tonyzhangforest/Intelligent-Toilet-Controller/智能马桶控制系器统需求.pdf

智能马桶控制器系统需求
基本功能：
⚫ | 水温控制，水温传感器
⚫ | 喷嘴位置控制，电机控制
⚫ | 喷嘴流量控制，阀门控制，流量传感器
⚫ | 空气泵控制
⚫ | 风温控制，风温传感器
⚫ | 座圈加热，温度传感器
⚫ | 按键面板和指示灯夜灯
⚫ | 电源转换，输出 12V/2A
以上各传感器等部件的控制全部在一颗 MCU 搞定，水温风温和座圈温均需要配套相关保险 机制，以免对人体造成伤害，另外需要有漏电保护机制；

选配：
⚫ | 人体感应装置，毫米波雷达芯片控制，包括自动掀盖和自动感应冲水以及脚感冲水；
⚫ | 紫外线功能；
⚫ | 电子除臭或活性炭；
⚫ | 联网功能；
⚫ | 支持外接电池（停电时使用）
⚫ | 定时及节能功能

疑问：
⚫ | 进水是否需要过滤；
⚫ | 防水等级；
⚫ | 是否需要相关行业认证；
⚫ | 是否需要遥控器；
⚫ | 按键光感何解；
