tonyzhangforest/Intelligent-Toilet-Controller/副本SHRZ_RZ01_V1.0-BOM20200424.xlsx

SHRZ_RZ01_V1.0-BOM
序号 | 名称 | 单板数量 | 位号 | 物料编码 | 规格 | 封装 | 供应商 | 供应商料号 | 备注
1 | 直插X2安规电容 | 1 | C1 | X2/1uF/275V | 15mm脚距 1uF 275V | X2-1770X960 |  |  | 参考https://detail.tmall.com/item.htm?id=544635025633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
2 | 直插电解电容 | 1 | C2 | RNU1C471MDN1PH/470uF/25V | RNU1C471MDN1PH | CAPPR500-1000X1250
3 | 直插电解电容 | 2 | C3,C4 | 47uF/400V | 47uF 400V 16*20mm | CAPPR750-1600X2000 |  |  | https://detail.tmall.com/item.htm?id=44162474692&cm_id=140105335569ed55e27b&abbucket=8&skuId=3832824949122
4 | 贴片陶瓷电容 | 1 | C5 | 1uF/100V/1206 | 1uF 100V 1206 X7R | C1206
5 | 直插Y2安规电容 | 1 | C6 | DE2E3KY222MA2BM01/2200pF/250V | DE2E3KY222MA2BM01 | dip-500p-800x500 | 国巨 | swssaas
6 | 贴片陶瓷电容 | 10 | C7,C11,C14,C19,C20,C21,C22,C23,C27,C30 | RZC100102 | 0.1uF 50V 0603 | C0603
 |  |  |  |  |  |  | 三星电子 | CL10F104ZB8NNNC
7 | 贴片陶瓷电容 | 2 | C8,C41 | 1nF/50V/6 | 1nF 50V 0603 X7R | C0603 | 三星电子 | CL10B102JB8NFNC
8 | 贴片陶瓷电容 | 1 | C9 | 4.7uF/35V/8 | 4.7uF 35V 0805 X7R | C0805 | 三星电子 | CL21A475KLCLQNC
9 | 贴片陶瓷电容 | 6 | C10,C12,C13,C15,C26,C29 | 1uF/25V/6 | 1uF 25V 0603 X7R | C0603 | 三星电子 | CL10A105KA8NFNC
10 | 贴片陶瓷电容 | 2 | C16,C17 | 10pF/50V/6 | 10pF 50V 0603 X7R | C0603 | 三星电子 | CL31B106KBHNFNE
11 | 贴片陶瓷电容 | 3 | C18,C31,C42 | 10uF/16V/8 | 10uF 16V 0805 X7R | C0805 | 三星电子 | CL21B106KOQNFNE
12 | 贴片陶瓷电容 | 2 | C24,C25 | 20pF/50V/6 | 20pF 50V 0603 X7R | C0603 | 三星电子 | CL10C200JB80PNC
13 | 贴片陶瓷电容 | 2 | C28,C43 | 0.1uF/50V/6/NC | 不贴 | C0603
14 | 直插X2安规电容 | 4 | C32,C33,C34,C35 | X2/0.01uF/275V | 10mm脚距 0.01uF 275V | x2-1300x600 |  |  | 参考https://detail.tmall.com/item.htm?id=544635025633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
15 | 贴片陶瓷电容 | 5 | C36,C37,C38,C39,C40 | 0.01uF/50V/6 | 0.01uF 50V 0603 X7R | C0603 |  | CL10B104JB8NNNC
16 | 贴片全桥整流桥 | 1 | D1 | DF06S | DF06S | DF06S
17 | 贴片单向TVS管 | 1 | D2 | SMBJ120A-13-F | SMBJ120A-13-F | SMB
18 | 贴片肖特基二极管 | 1 | D3 | MURS360S | MURS360S | SMB
19 | 贴片超快恢复二极管 | 1 | D4 | US1K-E3/61T | US1K-E3/61T | SMA |  | Vishay
20 | 贴片红色LED | 1 | D5 | RLED | 红色发光二极管 0603 | led0603
21 | 贴片双向ESD管 | 5 | D10,D11,D12,D13,D14 | SS14 | SS14,SMA | SMA
22 | 贴片肖特基二极管 | 4 | D15,D16,D17,D18 | TMG8C80F | TMG8C80F | TO-220 |  | SanRex
23 | 直插Triac | 8 | ED1,ED2,ED3,ED4,ED5,ED6,ED7,ED8 | ESD9B5V | 贴片双向ESD管 | D0402
24 | 直插快熔断陶瓷保险丝 | 1 | F1 | 250AC/10A/3.6*10 | 带引线快融陶瓷保险丝 250V 10A 3.6mm*10mm | DIP-F360X1000
25 | 直插快熔断陶瓷保险丝 | 1 | F2 | 250AC/0.5A/3.6*10 | 带引线快融陶瓷保险丝 250V 0.5A 3.6mm*10mm | DIP-F360X1000
26 | 直插2脚连接器 | 2 | J1,J14 | CON2 | 7.8mm间距插件，网上没看到实物图片 | DIP780-1580x850-2N
27 | 直插2脚连接器 | 1 | J2 | CON2 | 2.54单排针直针2P | DIP254P-1X2 |  |  | https://item.taobao.com/item.htm?id=549095567003&ali_trackid=1_d2534dbc00c9d3ae4bf6c6e66d614638
28 | 直插4脚连接器 | 1 | J3 | CON4 | XH2.54MM连接器直针插座4P | XH2-54-1X4 |  |  | https://detail.tmall.com/item.htm?id=13300685584&ali_trackid=1_cd4177326dbb2e69d96db1ddd9ae0f90
29 | 直插3脚连接器 | 3 | J4,J20,J21 | CON3 | XH2.54MM连接器直针插座3P | XH2-54-1X3 |  |  | https://detail.tmall.com/item.htm?id=13300685584&ali_trackid=1_cd4177326dbb2e69d96db1ddd9ae0f90
30 | 直插2脚连接器 | 10 | J5,J6,J7,J8,J9,J10,J16,J17,J18,J19 | CON2 | XH2.54MM连接器直针插座2P | XH2-54-1X2 |  |  | https://detail.tmall.com/item.htm?id=13300685584&ali_trackid=1_cd4177326dbb2e69d96db1ddd9ae0f90
31 | 直插5脚连接器 | 2 | J11,J12 | CON5 | XH2.54MM连接器直针插座5P | XH2-54-1X5 |  |  | https://detail.tmall.com/item.htm?id=13300685584&ali_trackid=1_cd4177326dbb2e69d96db1ddd9ae0f90
32 | 直插2脚连接器 | 2 | J13,J15 | CON2 | 5557端子接插件 直针 | 5569-420-2N |  |  | https://item.taobao.com/item.htm?id=12846741848
33 | 直插6脚连接器 | 1 | J22 | CON6 | XH2.54MM连接器直针插座6P | XH2-54-1X6 |  |  | https://detail.tmall.com/item.htm?id=13300685584&ali_trackid=1_cd4177326dbb2e69d96db1ddd9ae0f90
34 | 直插2脚端子 | 1 | J23 | CON2 | 6.3H脚PC板插片焊片 | DIP480P-2N |  |  | https://item.taobao.com/item.htm?id=528256841030&ns=1&abbucket=19
35 | 直插4脚连接器 | 1 | J24 | CON4A | 直插双排4脚跳线帽插针 | DIP254P-2X2
36 | 贴片磁珠 | 2 | LFB1,LFB2 | CBW160808U601T/1A/6 | CBW160808U601T | L0603
37 | 直插压电蜂鸣器 | 1 | LS1 | SPEAKER | 1407型压电蜂鸣器 | B1407 |  |  | 有源无源待定
38 | 直插共模电感 | 1 | L1 | 5mH/1.5A/7*8 | 5mH，1.5A，7mm*8mm | L_7X8-4 |  |  | https://detail.tmall.com/item.htm?spm=a1z0d.6639537.1997196601.46.75637484LeTp8T&id=41299186690
39 | 贴片功率电感 | 1 | L2 | NPI31W471MTRF/470uH/0.5A | NPI31W471MTRF | NPI31W471MTRF
40 | 贴片三端基准电压源 | 1 | Q1 | TL432IDBZ | TL432IDBZ | sot23
41 | 贴片三极管 | 3 | Q2,Q10,Q11 | MMBT3906LT1G | PNP | SOT23
42 | 贴片三极管 | 7 | Q3,Q4,Q5,Q6,Q7,Q8,Q9 | MMBT3904LT1G | NPN | SOT23
43 | 贴片MOS管 | 1 | Q12 | AO3407A/NC | 不贴 | SOT23
44 | 直插功率热敏电阻 | 1 | RT1 | NTC10D-9 | NTC10D-9 | ntc10d-9
45 | 贴片电阻 | 4 | R1,R2,R102,R103 | 1M/1206 | RES,1M,5%,0.25W,1206 | R1206
46 | 贴片电阻 | 1 | R3 | R050/2512 | RES,0.05,1%,2W,2512 | R2512
47 | 贴片电阻 | 1 | R17 | R500/2512 | RES,0.5,1%,2W,2512 | R2512
48 | 贴片电阻 | 1 | R4 | 365K/6 | RES,365K,5%,0.1W,0603 | R0603
49 | 贴片电阻 | 1 | R5 | 10R/8 | RES,10,5%,0.125W,0805 | R0805
50 | 贴片电阻 | 1 | R6 | 301K/1%6 | RES,301K,5%,0.1W,0603 | R0603
51 | 贴片电阻 | 13 | R7,R24,R25,R26,R36,R59,R60,R71,R72,R88,R89,R90,R91 | 10K/6 | RES,10K,5%,0.1W,0603 | R0603
52 | 贴片电阻 | 1 | R8 | 71.5K/1%/6 | RES,71.5K,1%,0.1W,0603 | R0603
53 | 贴片电阻 | 1 | R9 | 22R/8 | RES,22,5%,0.125W,0805 | R0805
54 | 贴片电阻 | 1 | R10 | 19.1K/1%/6 | RES,19.1K,1%,0.1W,0603 | R0603
55 | 贴片电阻 | 1 | R11 | 44.2K/1%/6 | RES,44.2K,1%,0.1W,0603 | R0603
56 | 贴片电阻 | 1 | R12 | 5.23K/1%/6 | RES,5.23K,1%,0.1W,0603 | R0603
57 | 贴片电阻 | 1 | R13 | 1.24K/1%/6 | RES,1.24K,1%,0.1W,0603 | R0603
58 | 贴片电阻 | 22 | R14,R22,R23,R27,R32,R33,R34,R37,R38,R39,R40,R44,R46,R49,R50,R79,R80,R81,R84,R85,R92,R93 | 1K/6 | RES,1K,5%,0.1W,0603 | R0603
59 | 贴片电阻 | 1 | R15 | 38.3K/1%/6 | RES,38.3K,1%,0.1W,0603 | R0603
60 | 贴片电阻 | 1 | R16 | 205K/1%/6 | RES,205K,1%,0.1W,0603 | R0603
61 | 贴片电阻 | 1 | R18 | 18.7K/1%/6 | RES,18.7K,1%,0.1W,0603 | R0603
62 | 贴片电阻 | 1 | R19 | 19.6K/1%/6 | RES,19.6K,1%,0.1W,0603 | R0603
63 | 贴片电阻 | 1 | R20 | 10K/1%/6 | RES,10K,1%,0.1W,0603 | R0603
64 | 贴片电阻 | 1 | R21 | 1M/6/NC | 不贴 | R0603
65 | 贴片电阻 | 3 | R28,R29,R45 | 100R/6 | RES,100,5%,0.1W,0603 | R0603
66 | 贴片电阻 | 3 | R30,R31,R78 | 4.7K/6 | RES,4.7K,5%,0.1W,0603 | R0603
67 | 贴片电阻 | 11 | R35,R41,R42,R43,R48,R51,R52,R62,R63,R73,R75 | 100K/6 | RES,100K,5%,0.1W,0603 | R0603
68 | 贴片电阻 | 1 | R47 | 220R/6 | RES,220,5%,0.1W,0603 | R0603
69 | 贴片电阻 | 8 | R53,R54,R61,R64,R65,R66,R74,R76 | 200R/8 | RES,200,5%,0.125W,0805 | R0805
70 | 贴片电阻 | 8 | R57,R58,R69,R70,R104,R105,R106,R107 | 100R/1206 | RES,100,5%,0.25W,1206 | R1206
71 | 贴片电阻 | 4 | R55,R56,R67,R68 | 510R/1206 | RES,510,5%,0.25W,1206 | R0805
72 | 贴片电阻 | 1 | R77 | 43K/2512 | RES,75K,1%,1W,2512 | R2512
73 | 贴片电阻 | 2 | R82,R87 | 6.8K/1%/6 | RES,6.8K,1%,0.1W,0603 | R0603 |  |  | 热敏电阻测温，阻值待定
74 | 贴片电阻 | 1 | R83 | 51K/1%/6 | RES,51K,1%,0.1W,0603 | R0603 |  |  | 热敏电阻测温，阻值待定
75 | 贴片电阻 | 1 | R86 | 33K/1%/6 | RES,33K,1%,0.1W,0603 | R0603 |  |  | 热敏电阻测温，阻值待定
76 | 贴片电阻 | 1 | R98 | 0R/8 | RES,0,5%,0.125W,0805 | R0805
77 | 贴片电阻 | 1 | R99 | 100K/6/NC | 不贴 | R0603
78 | 贴片电阻 | 1 | R100 | 1K/6/NC | 不贴 | R0603
79 | 贴片电阻 | 1 | R101 | 0R/1206/NC | 不贴 | R1206
80 | 直插变压器 | 1 | T1 | TRAN_ISDN_10 | 直插12脚，反激式变压器 | T_30X17-12 |  |  | 定制
81 | IC | 1 | U1 | UCC24636DBVR | 贴片IC | sot23_6 |  | TI
82 | IC | 1 | U2 | UCC28740DR | 贴片IC | soic127p600x175-7 |  | TI
83 | IC | 1 | U3 | EL817S1(B)(TU) | 贴片IC | SOIC254P760X460-4 |  | EVERLIGHT
84 | IC | 1 | U4 | MC7805BDTG/L7805CDT-TR | 贴片IC,两个型号均可 | TO252 |  | ON/ST
85 | IC | 1 | U5 | LP3987H-33B5F/RT9013-33GB | 贴片IC,两个型号均可 | SOT23-5 |  | LowPowerSemi/RICHTEK
86 | IC | 1 | U6 | STM32F103R8T6 | 贴片IC | TSQFP50P1200X1200X145-64 |  | ST
87 | IC | 1 | U7 | SGM803-SXN3L/NC | 不贴 | SOT-23
88 | IC | 1 | U8 | CAT24C64WI−GT3/CAT24C64WI-GT | 贴片IC,两个型号均可 | SOIC127P600X175-8 |  | ATMEL/ON
89 | IC | 1 | U9 | ULN2803ADWR | 贴片IC | SOIC127P1032X265-18 |  | TI
90 | IC | 4 | U10,U11,U12,U13 | MOC3063 | 直插IC,注意是小封装的直插封装 | DIP254-760X660-6 |  | LITEON,ON
91 | IC | 1 | U14 | EL354N（TA）-G | 贴片IC | SOIC254P440X410-4 |  | EVERLIGHT
92 | 贴片MOS | 2 | VQ1,VQ2 | SiHD6N65E/STD12N65M2 | 增强型NMOS,STD12N65M2 | TO-252 |  | ST
93 | 贴片MOS | 5 | VQ3,VQ4,VQ5,VQ6,VQ7 | AO3404A | 增强型NMOS | SOT23
94 | 直插压敏电阻 | 1 | VR1 | MYG3-10D431K | 10D431K,275V | MYG3-10D431K
95 | 贴片2脚无源晶体 | 1 | X1 | 32.768KHz/CL=7pF | 32.768KHz,CL=7pF,FC-135 | SMD3215
96 | 贴片2脚无源晶体 | 1 | X2 | 8MHz/CL=12pF | 8MHz,CL=12pF,5032 | crytal_17x24
 | 20200418注：红色字体跟上一版对应项不一样
 | 20200421注：增加连接器的描述
 | 20200423注：R55,R56,R67,R68由0805封装更改为1206封装；增加R104,R105,R106,R107等四个电阻
 | 20200424注：R22和R23由不贴的10K电阻更改为1K电阻，增加J24跳线帽
