tonyzhangforest/Intelligent-Toilet-Controller/KEY&LED.pdf

5

4

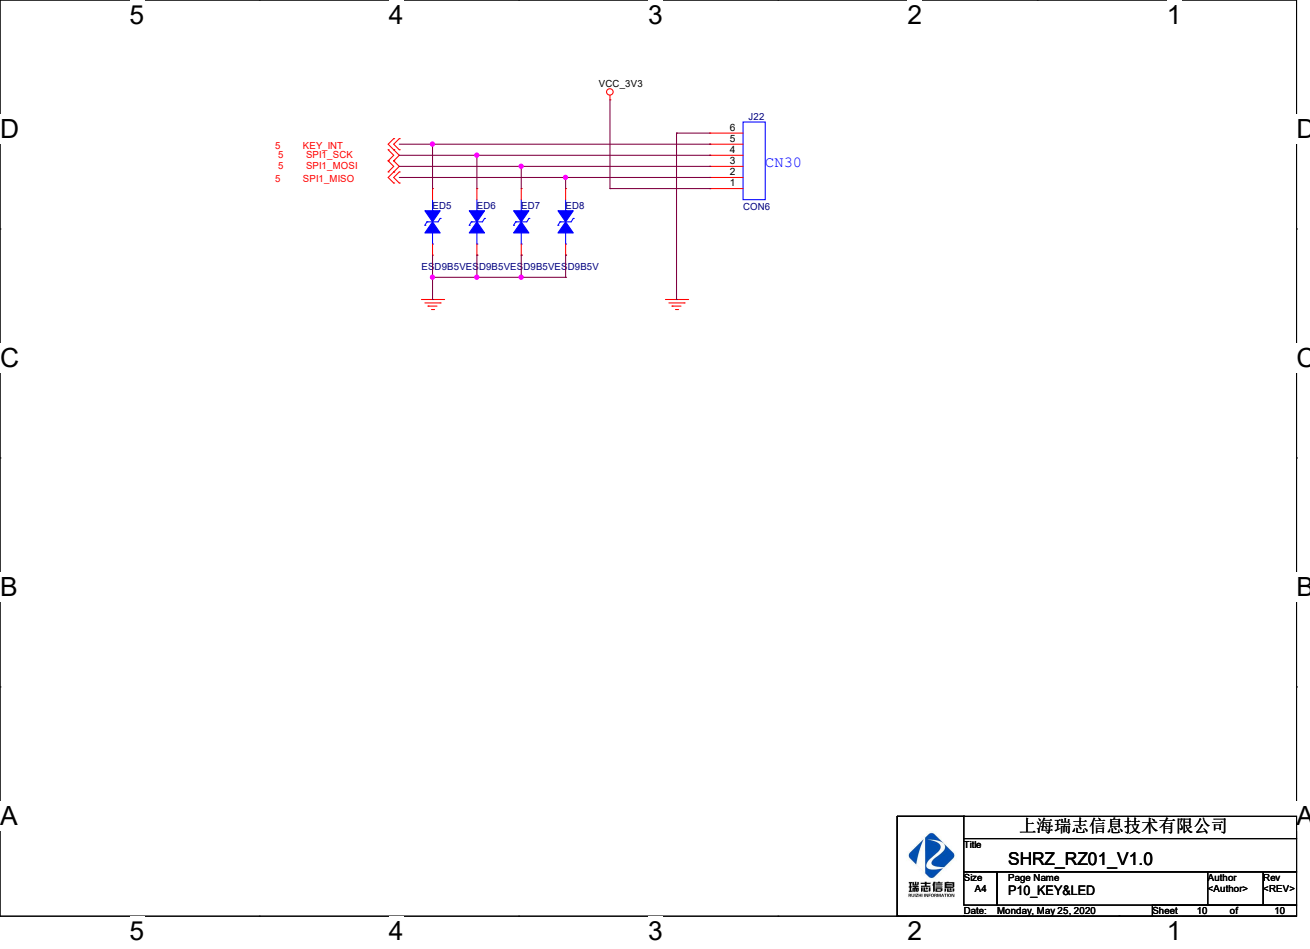
[picture p5: page 1]
CN30 VCC_3V3; 5 SPI1_SCK; SPI1_MOSI 5; SPI1_MISO; 5 KEY_INT; Title Size; Page Name; Rev Date:; Sheet; 上海瑞志信息技术有限公司Author SHRZ_RZ01_V1.0 A4 Monday, May 25, 2020; 10 P10_KEY&LED; <Author>; <REV> Title Size; <REV>; ED5 ESD9B5V; ED7 ESD9B5V; ED6 ESD9B5V; ED8 ESD9B5V; J22 CON6
