tonyzhangforest/Intelligent-Toilet-Controller/RZ01-HMI-V1.pdf

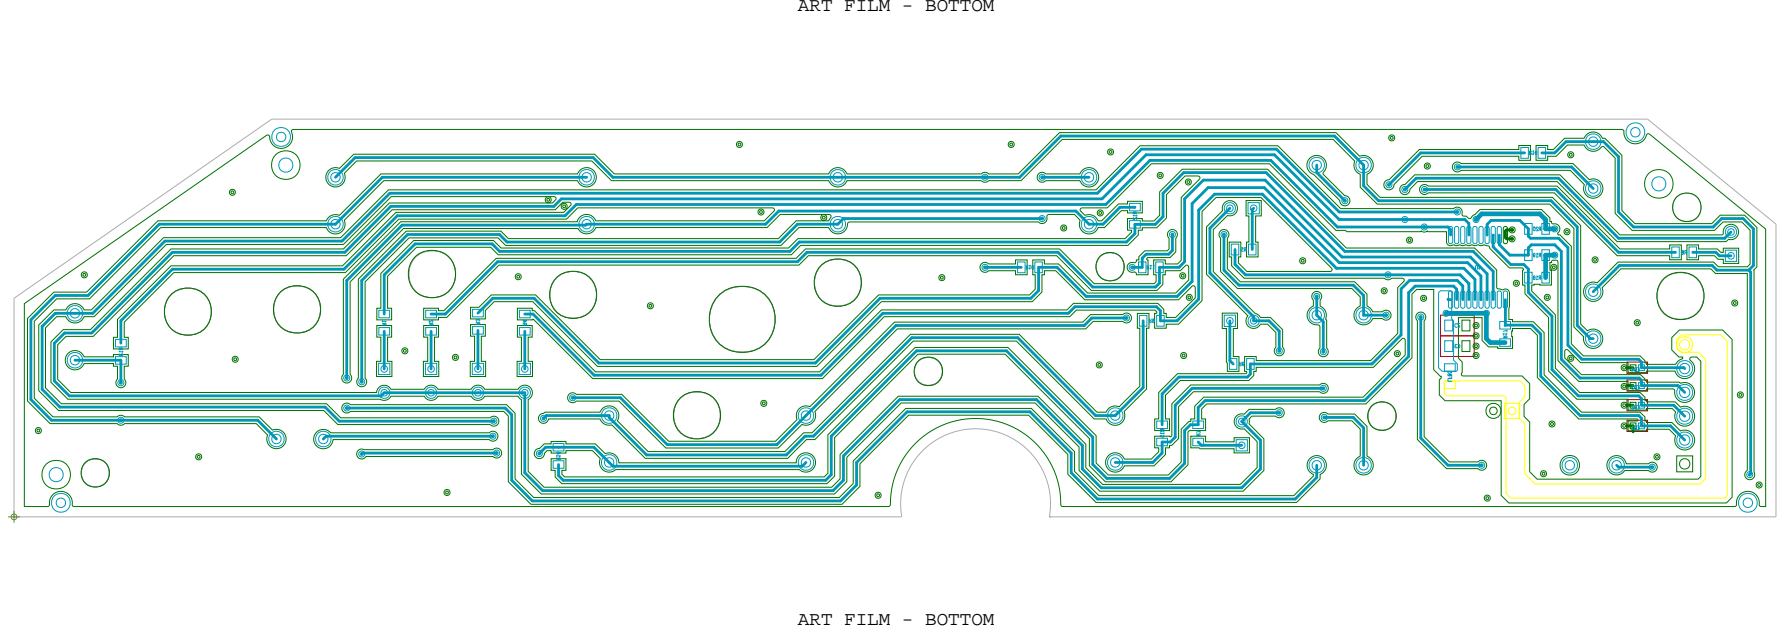
[picture p6: page 1]

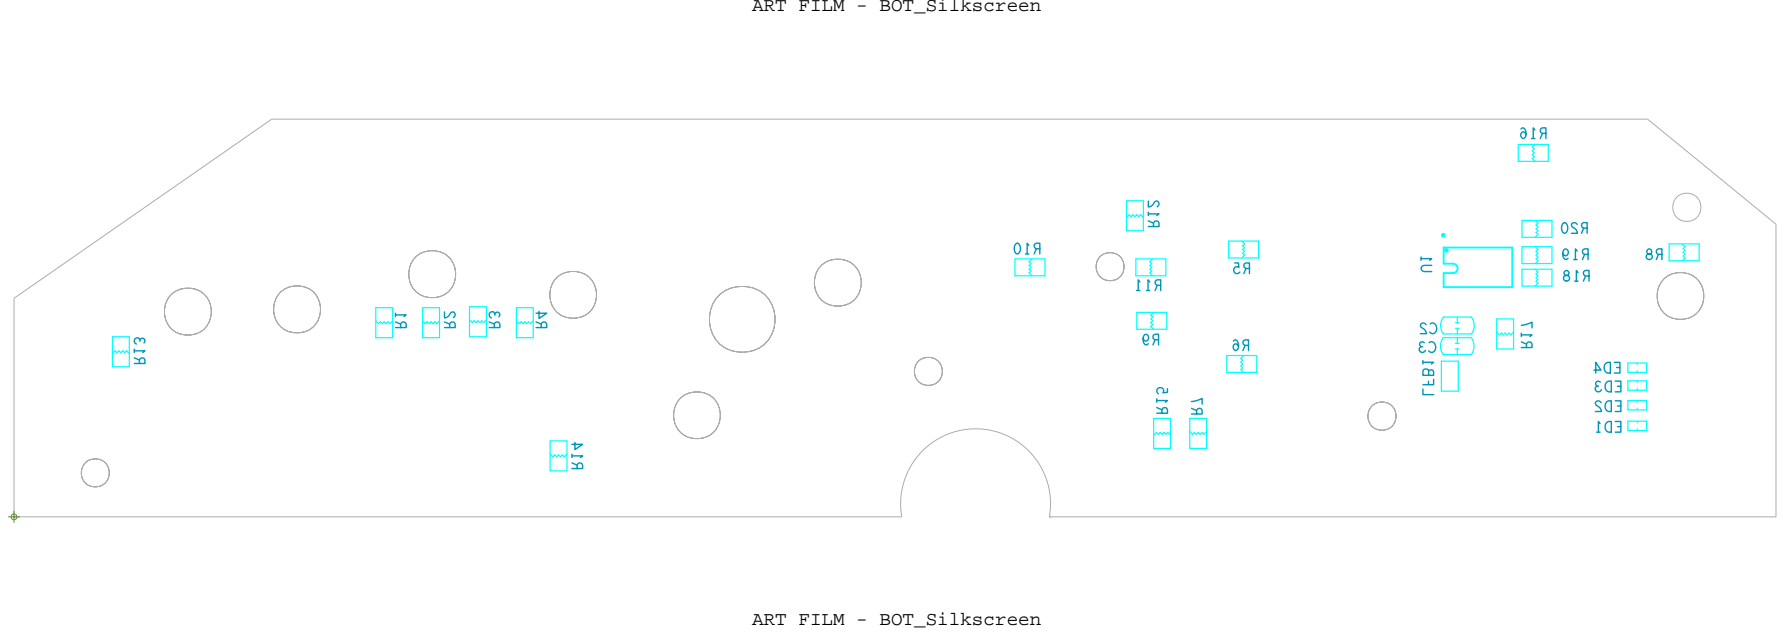
[picture p7: page 2]

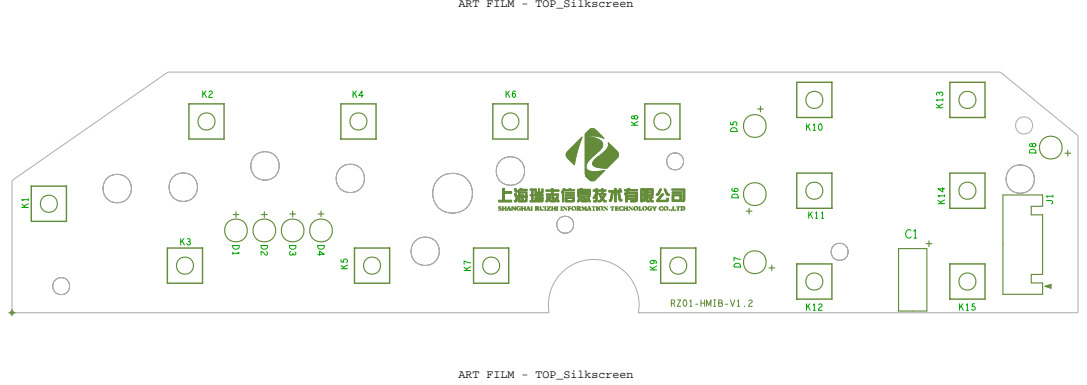
[picture p8: page 3]

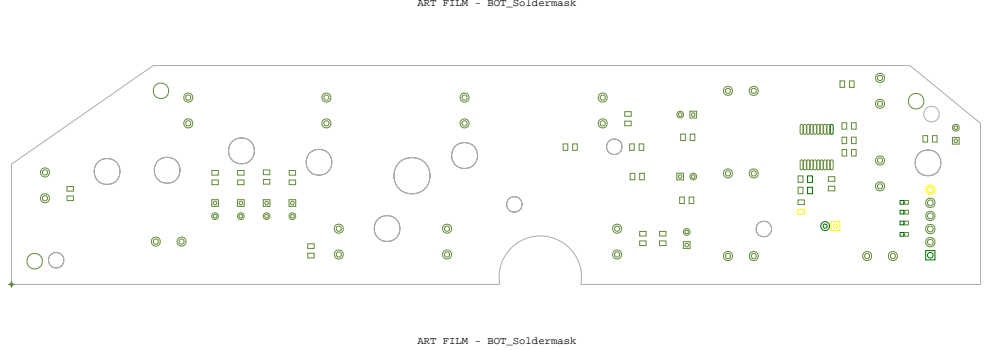
[picture p9: page 4]
ART FILM - BOT_Soldermask

188

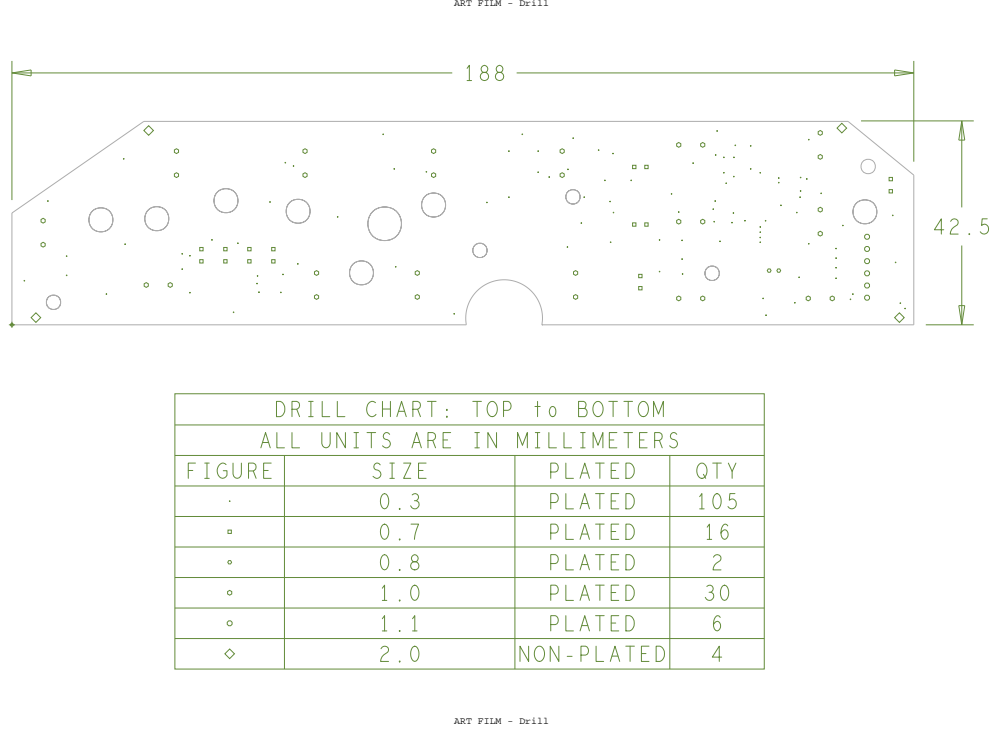
[picture p10: page 5]
QTY 105 16 2 30 6 4; PLATED PLATED PLATED PLATED PLATED PLATED NON-PLATED; SIZE 0.3 0.7 0.8 1.0 1.1 2.0

ART FILM - Drill

DRILL CHART: TOP to BOTTOM
ALL UNITS ARE IN MILLIMETERS
FIGURE

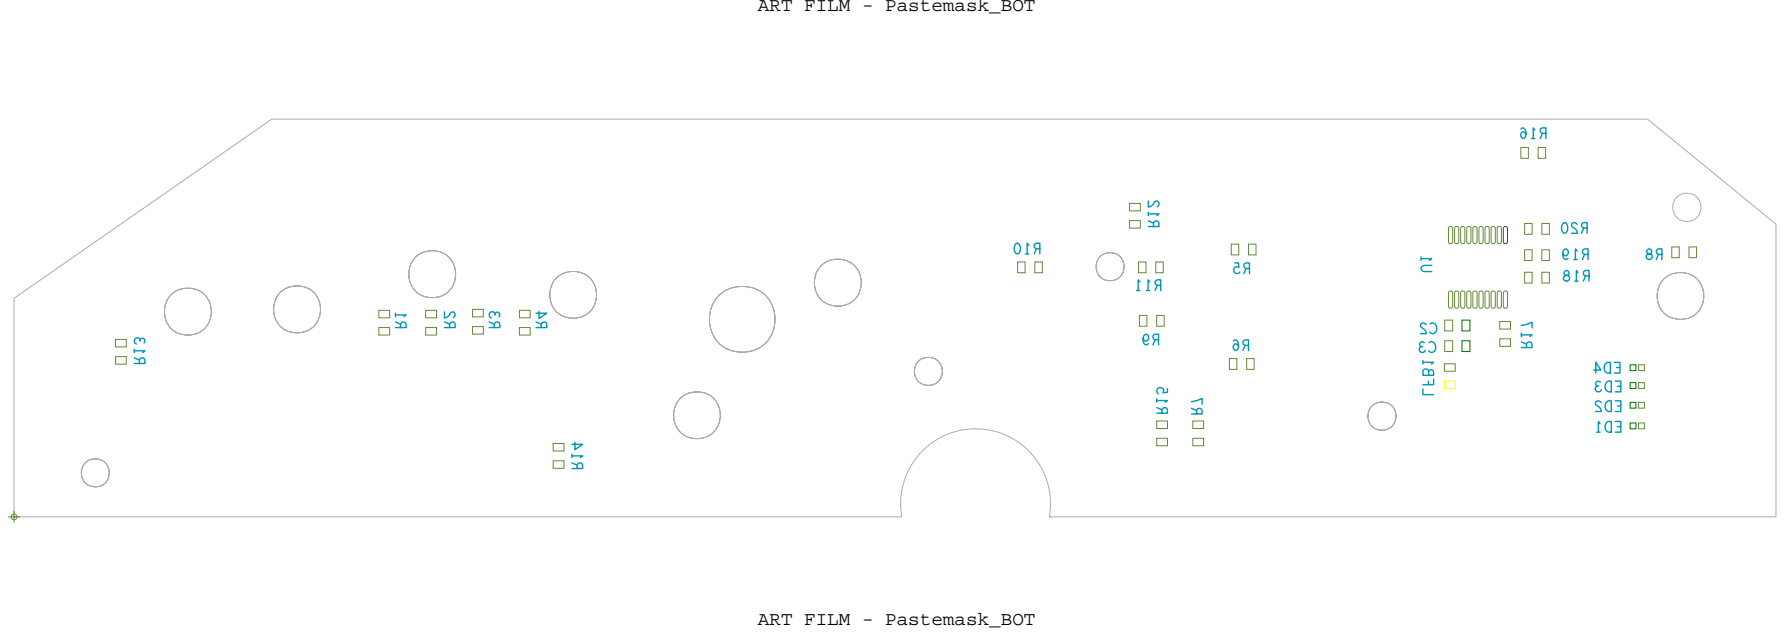
[picture p11: page 6]

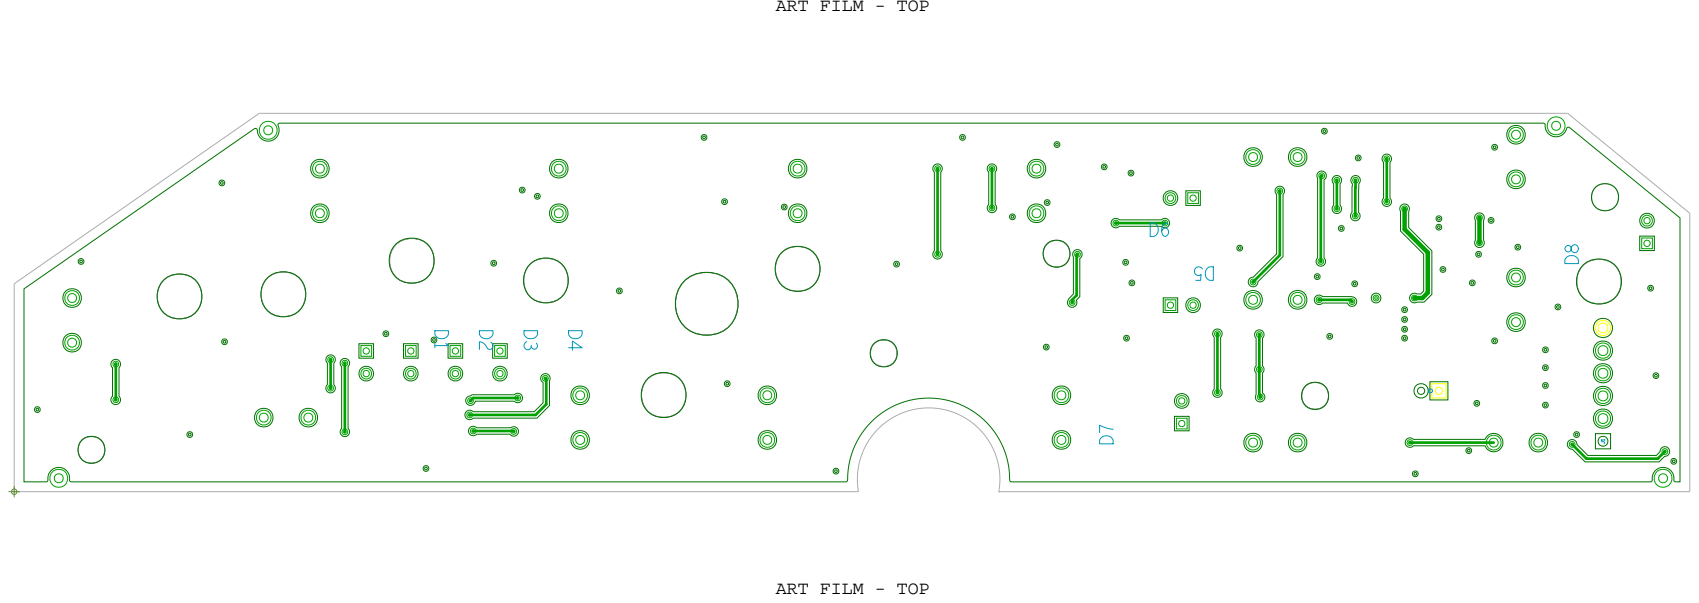
[picture p12: page 7]

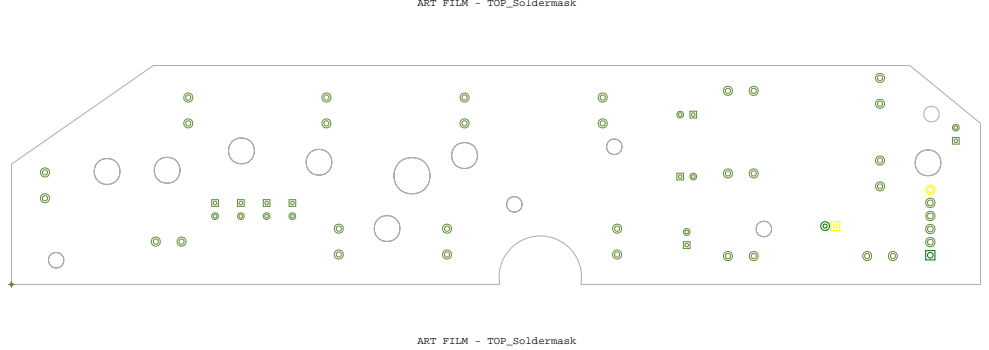
[picture p13: page 8]
ART FILM - TOP_Soldermask
