tonyzhangforest/Intelligent-Toilet-Controller/RZ01-HMIB-V1.pdf

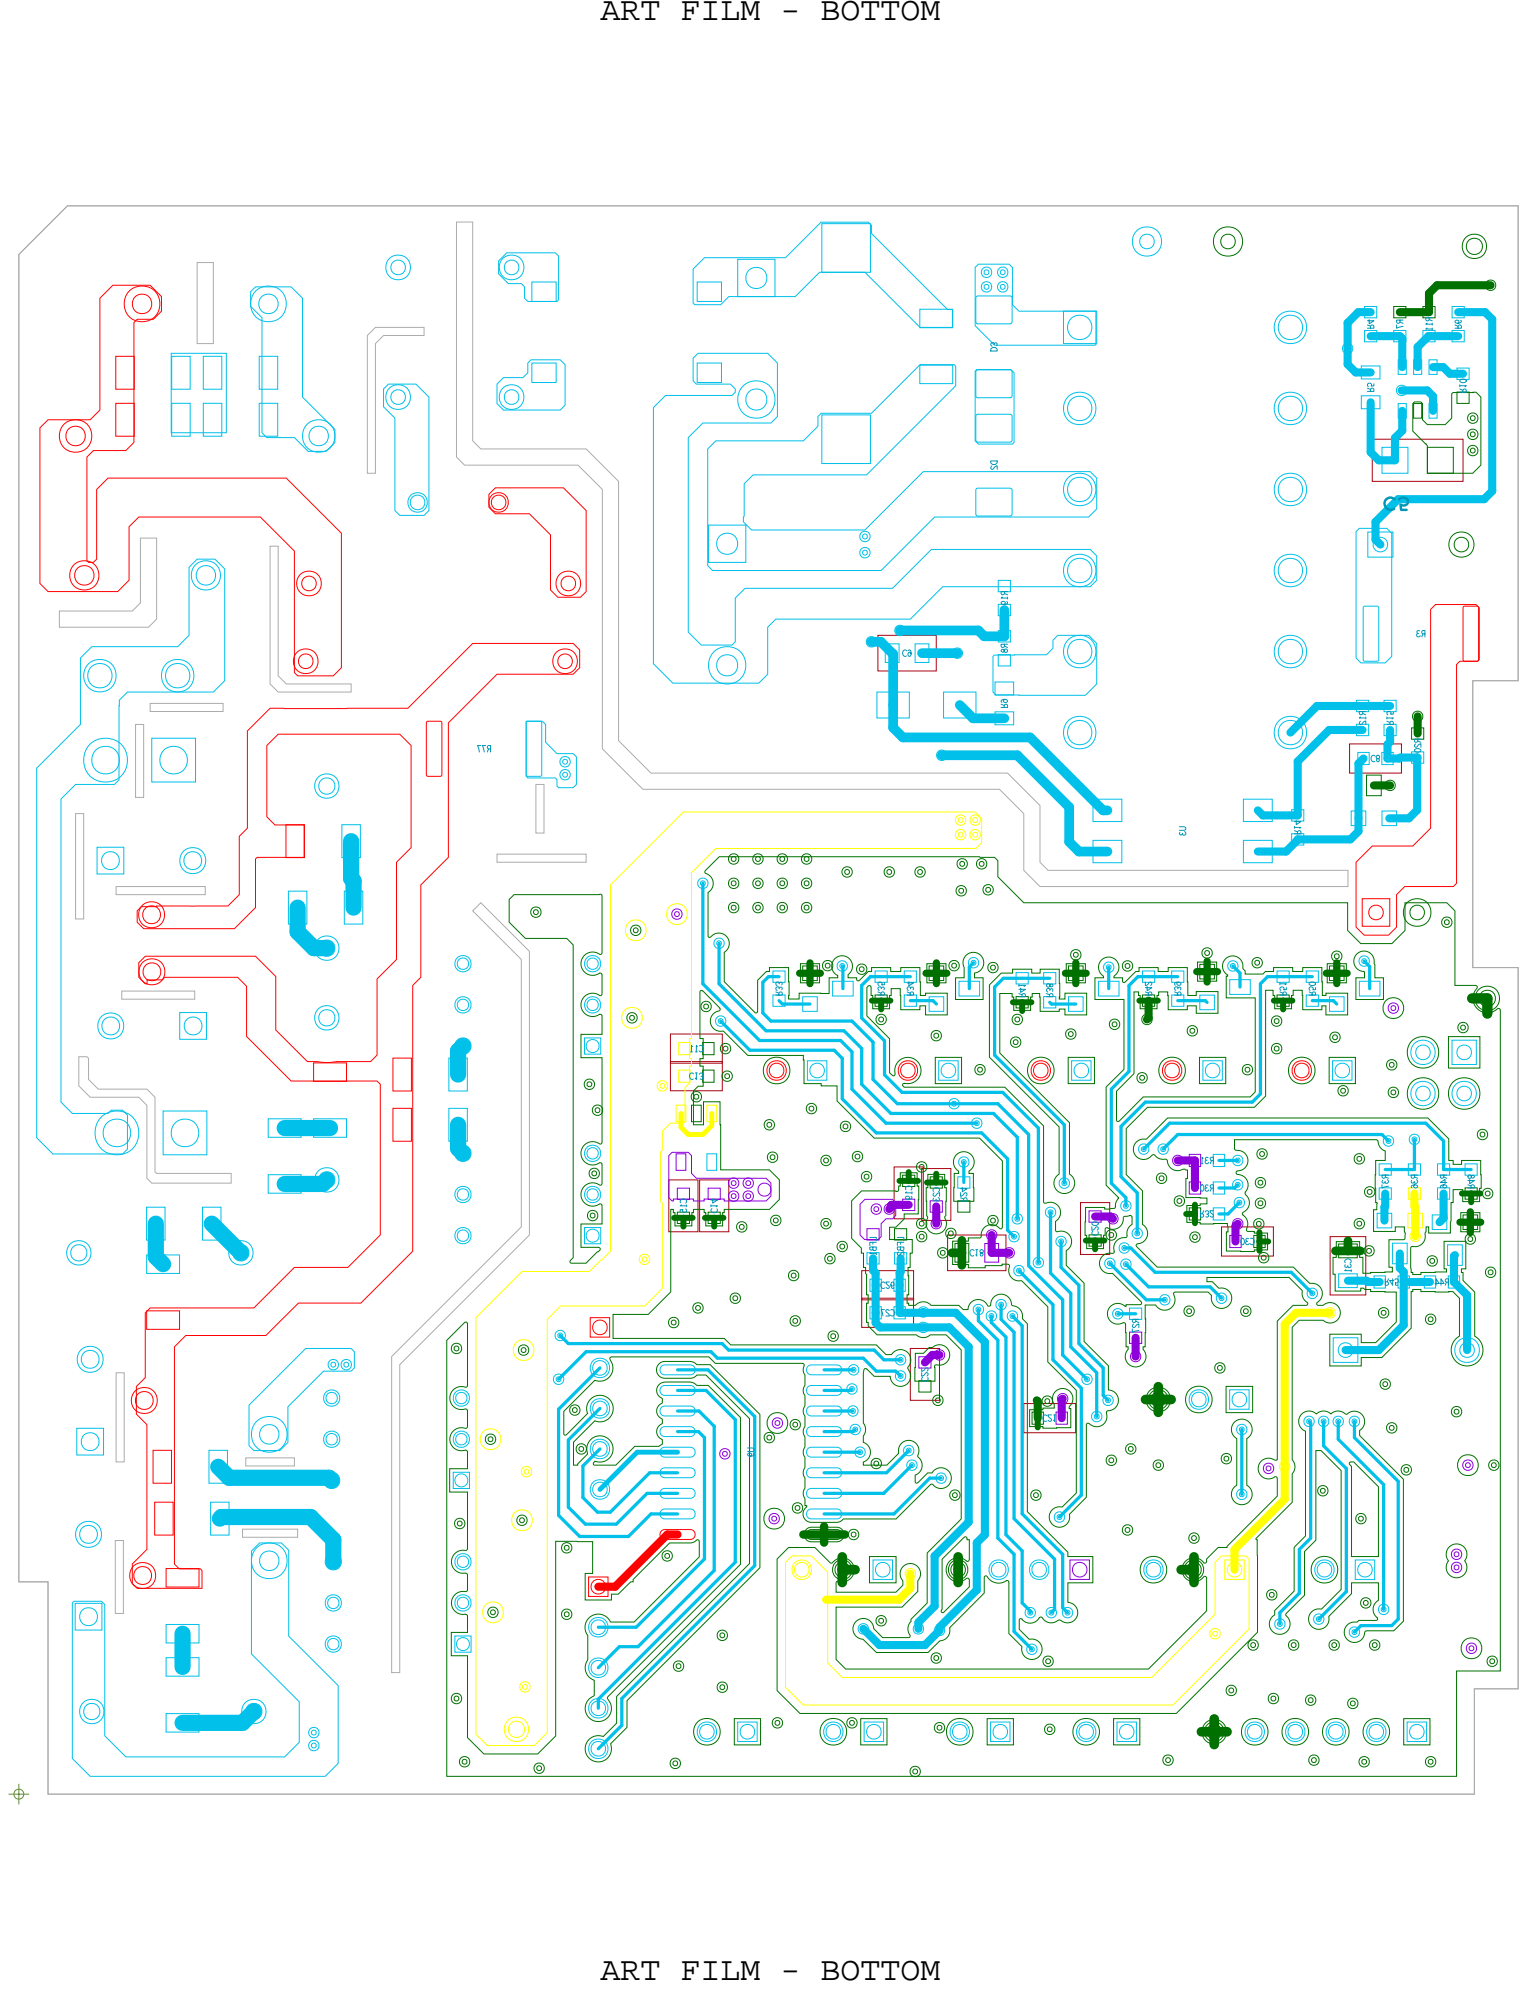
[picture p14: page 1]

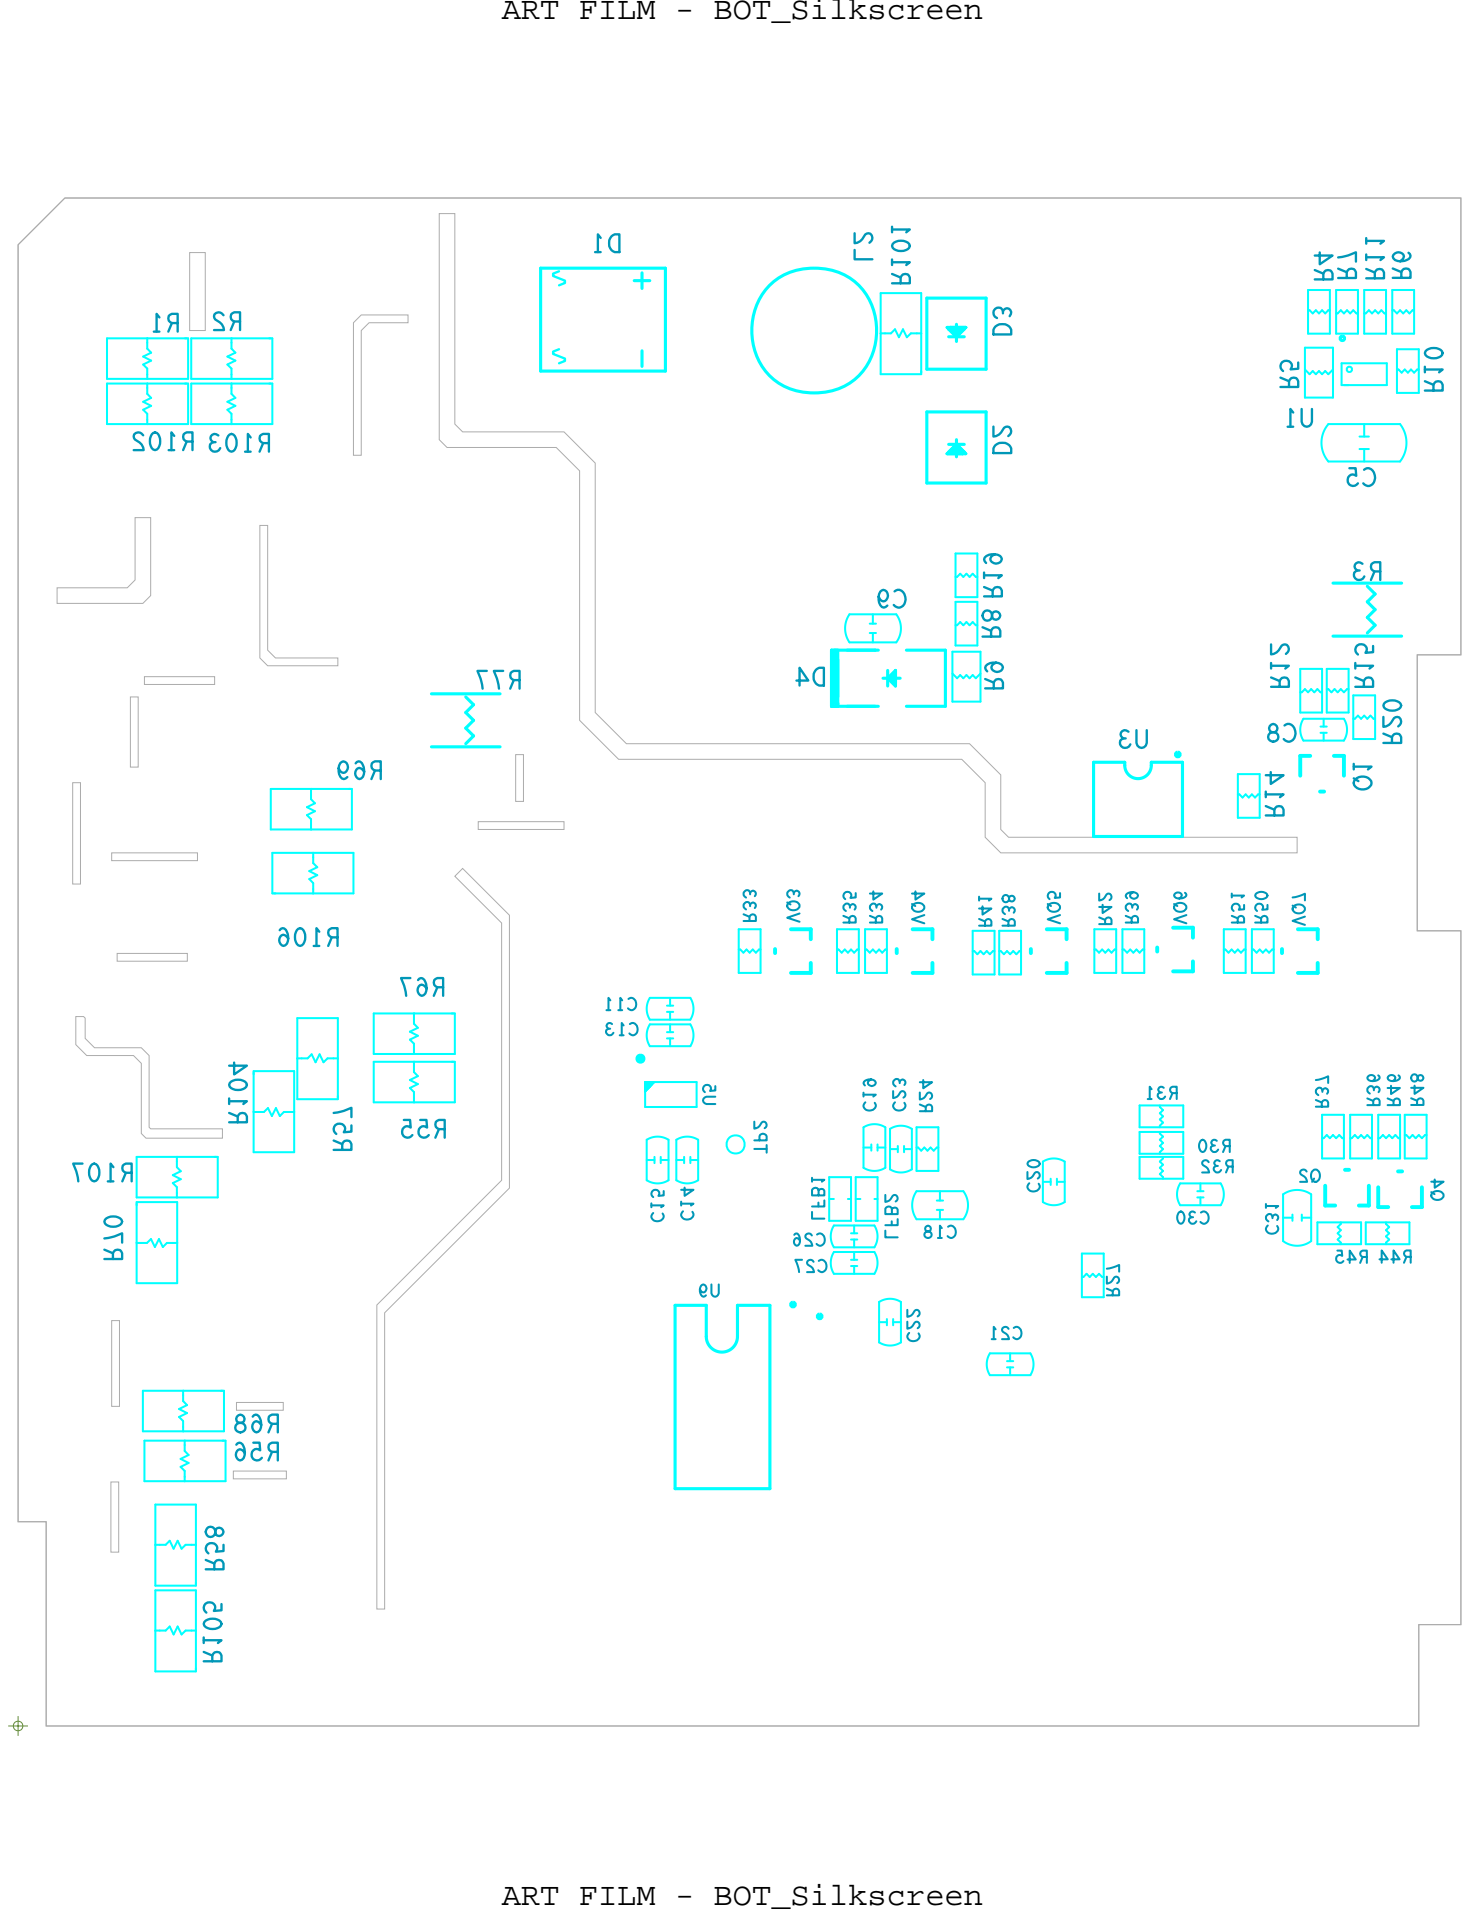
[picture p15: page 2]

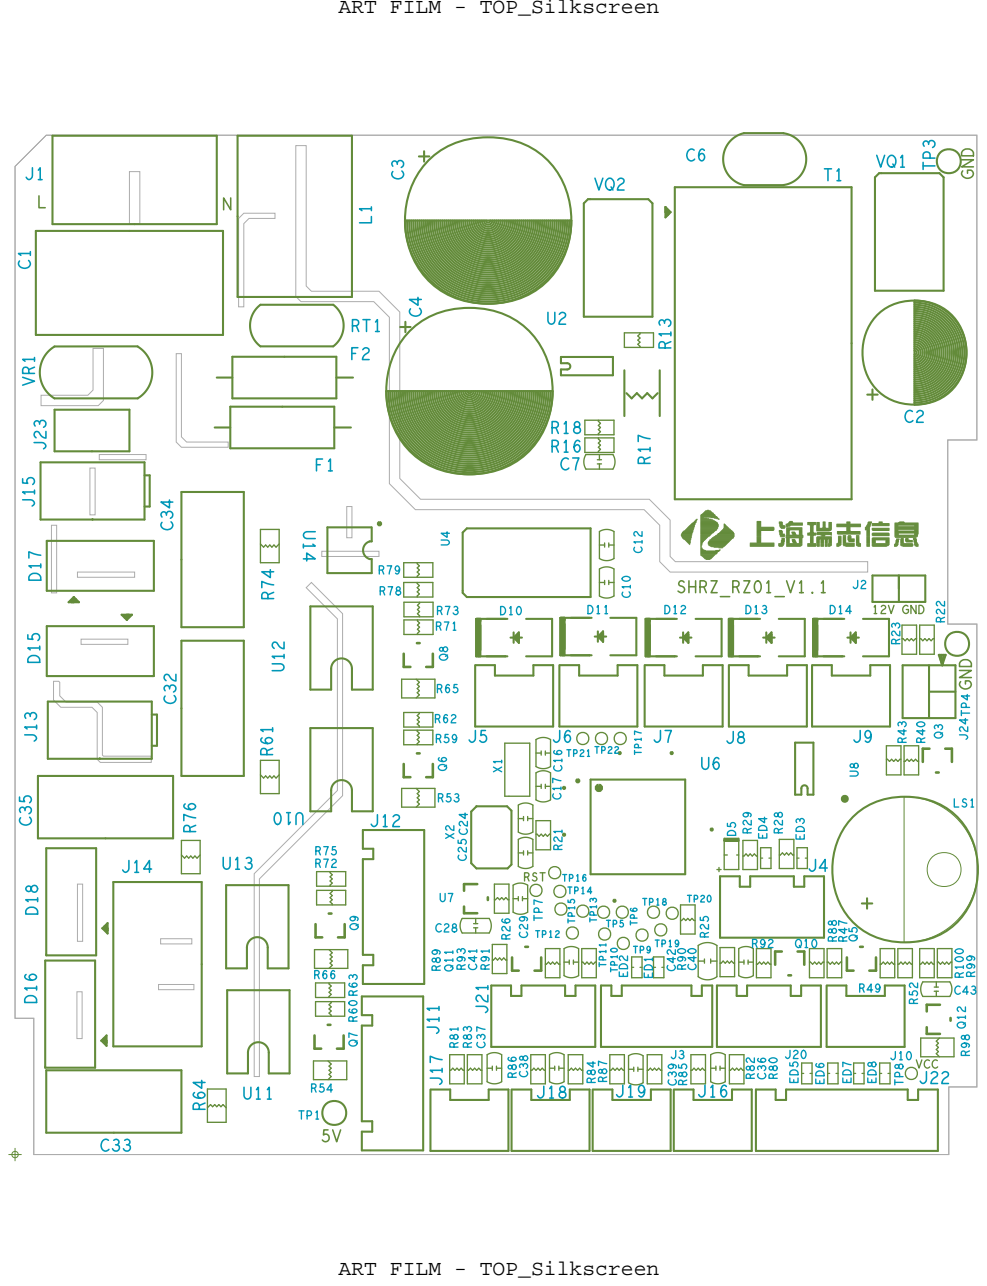
[picture p16: page 3]

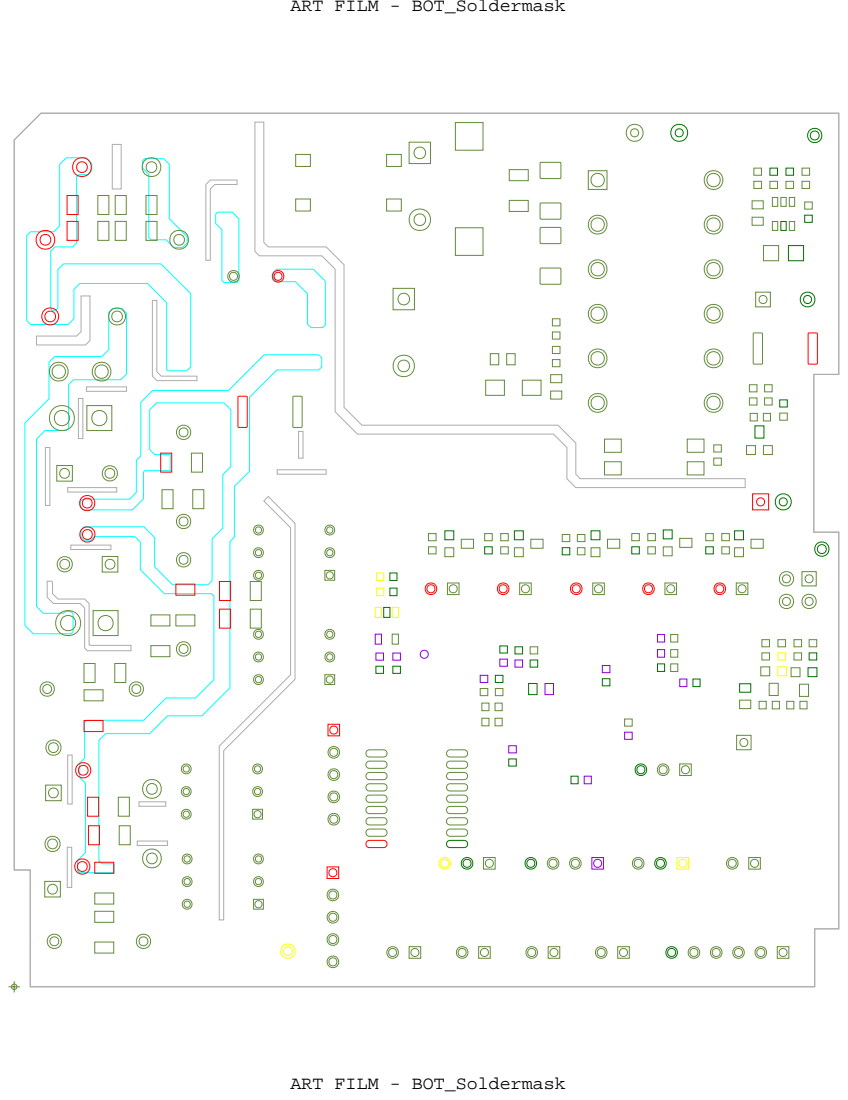
[picture p17: page 4]
ART FILM - BOT_Soldermask

98

92.5

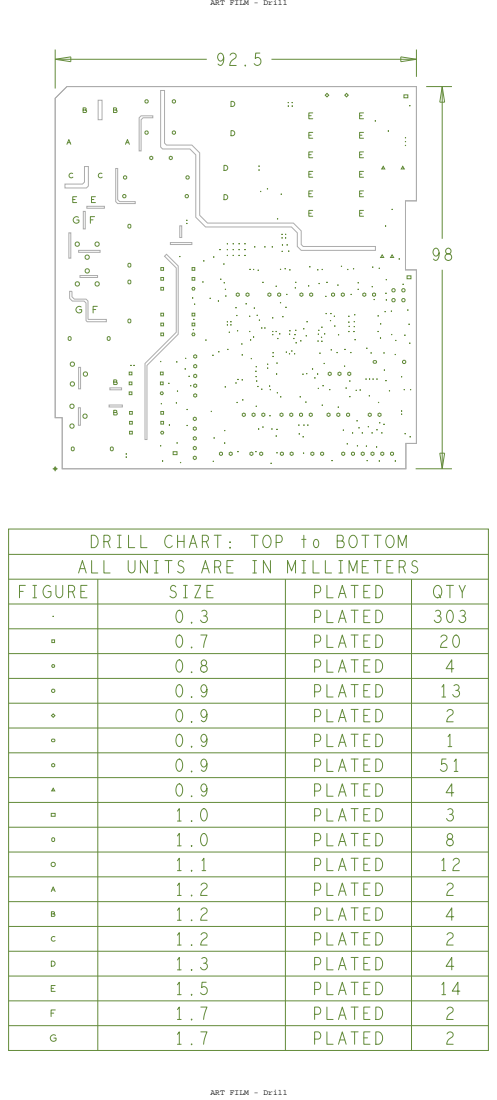
[picture p18: page 5]
QTY 303; PLATED PLATED PLATED PLATED PLATED PLATED PLATED PLATED PLATED PLATED PLATED PLATED PLATED PLATED PLATED PLATED PLATED PLATED PLATED; SIZE

ART FILM - Drill

DRILL CHART: TOP to BOTTOM
ALL UNITS ARE IN MILLIMETERS
FIGURE

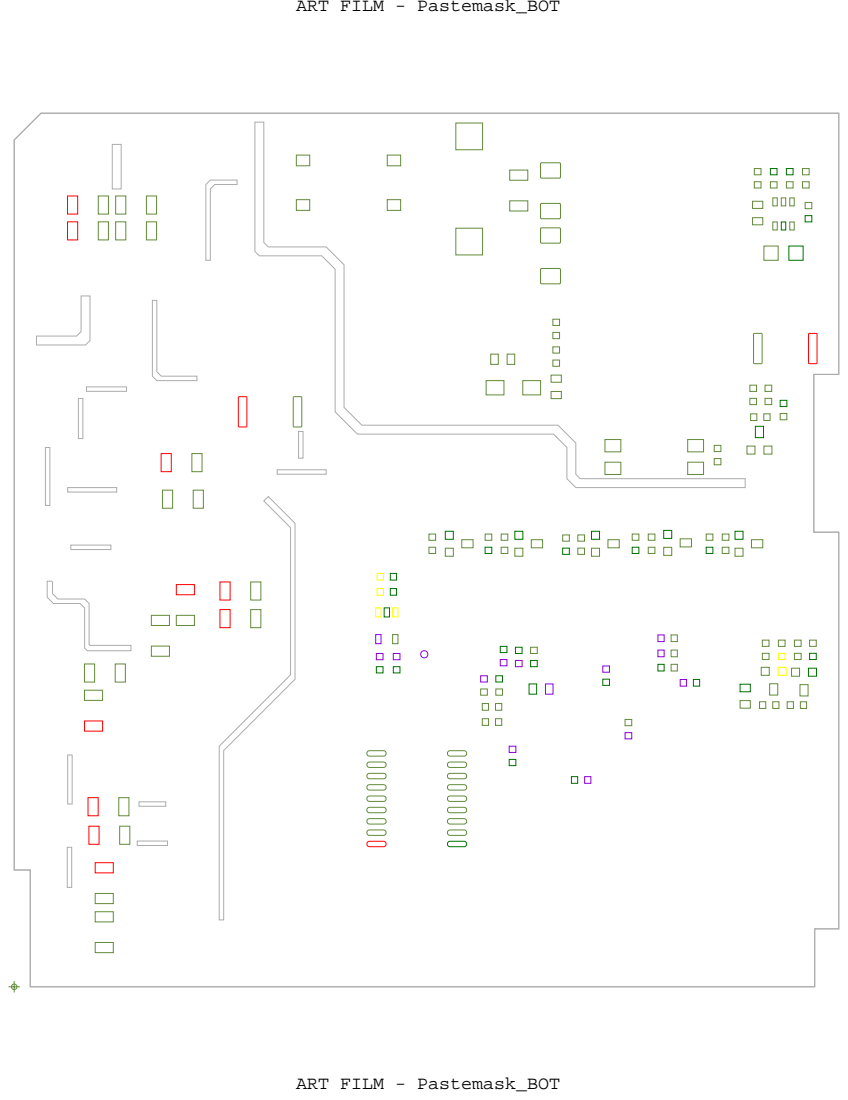
[picture p19: page 6]
ART FILM - Pastemask_BOT

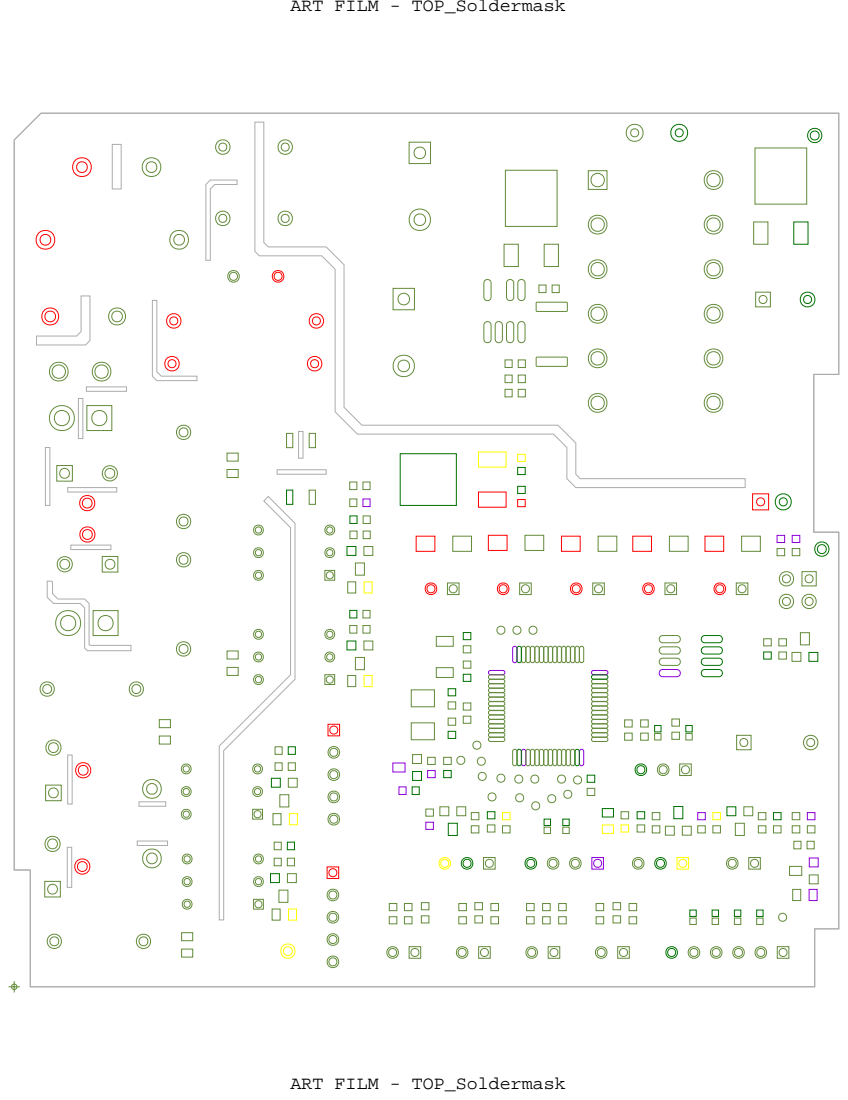
[picture p20: page 7]
ART FILM - TOP_Soldermask

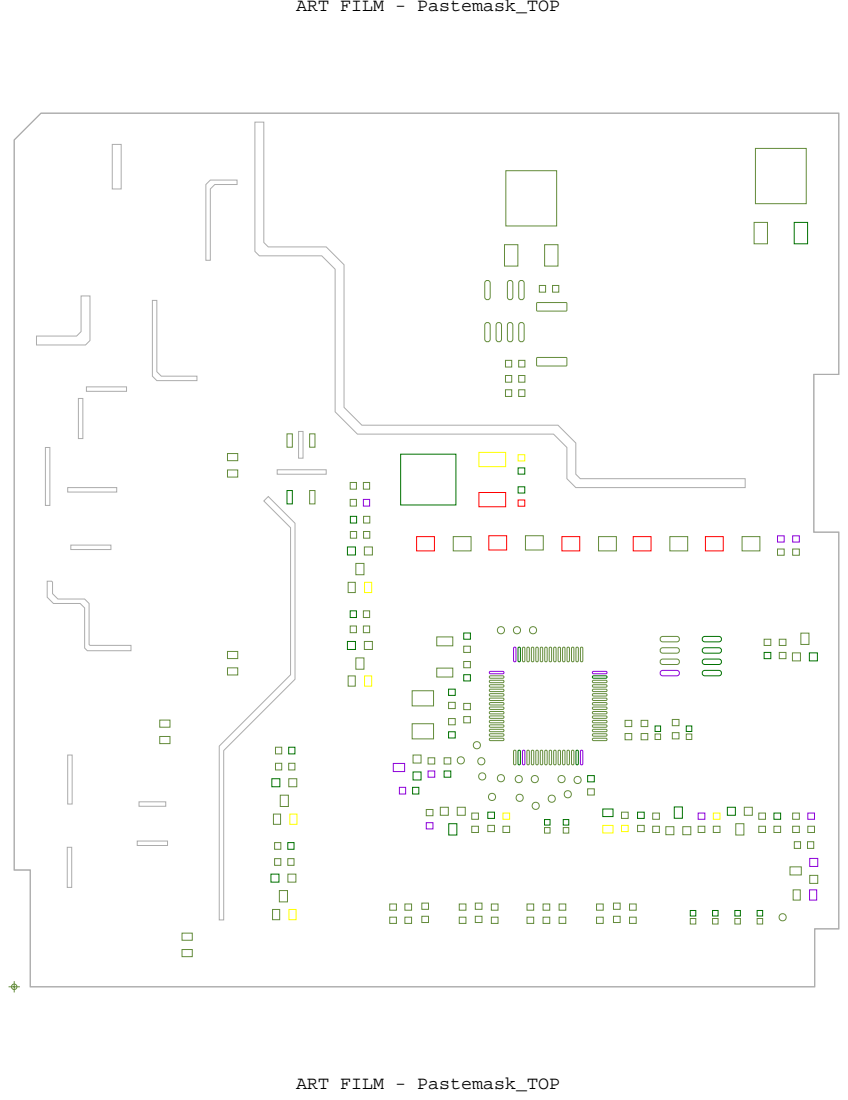
[picture p21: page 8]
ART FILM - Pastemask_TOP

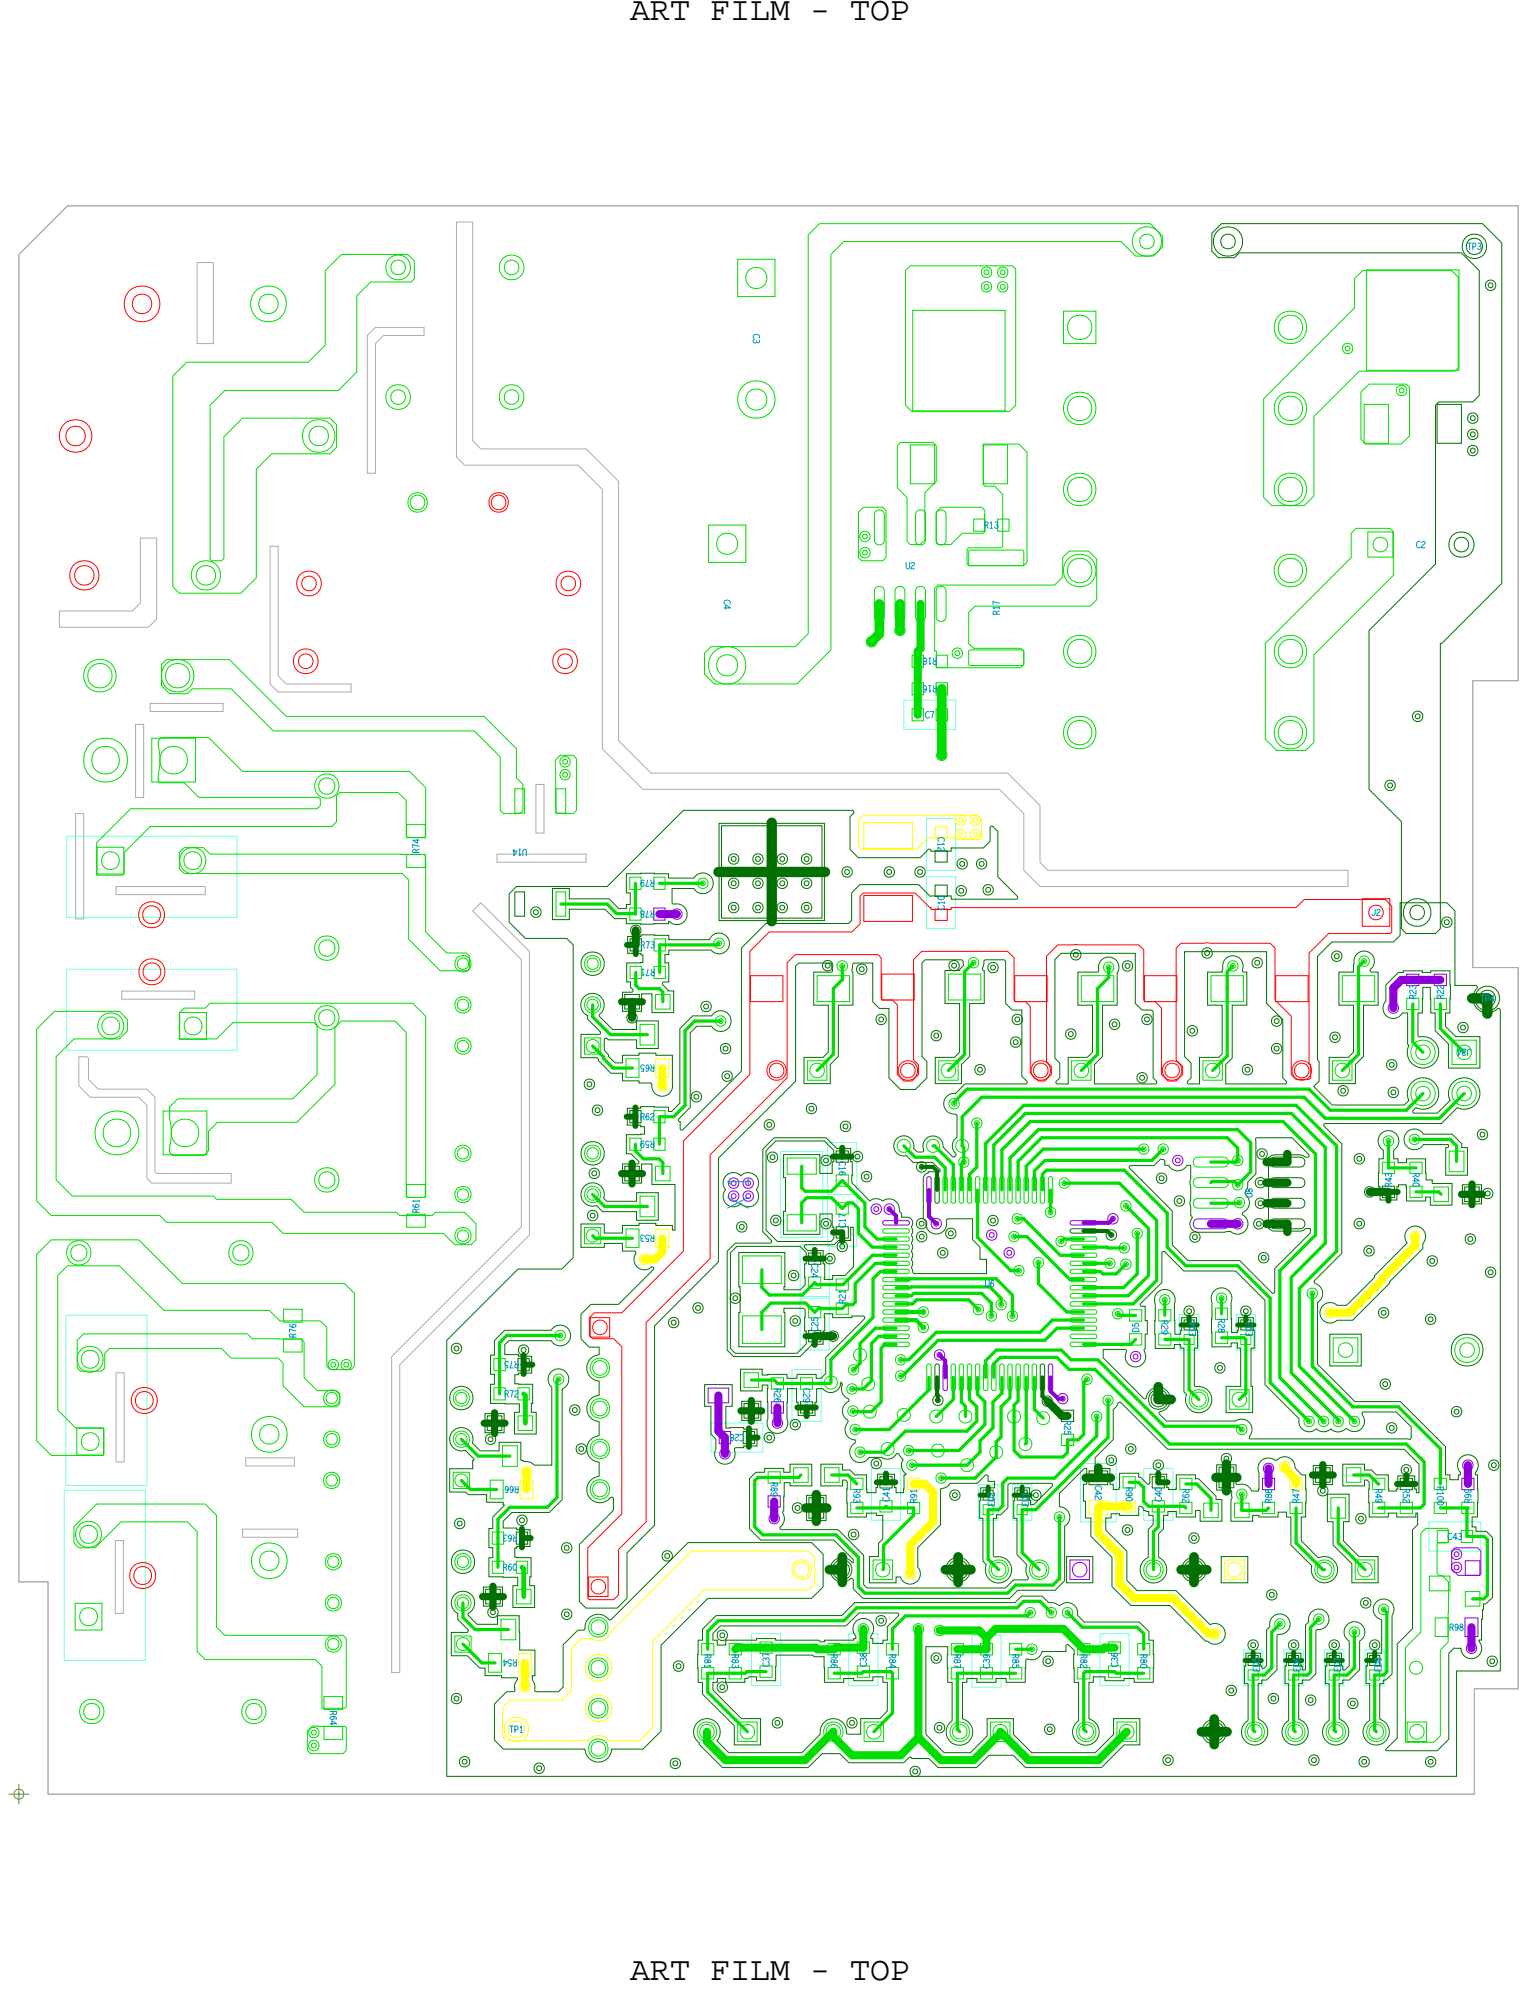
[picture p22: page 9]

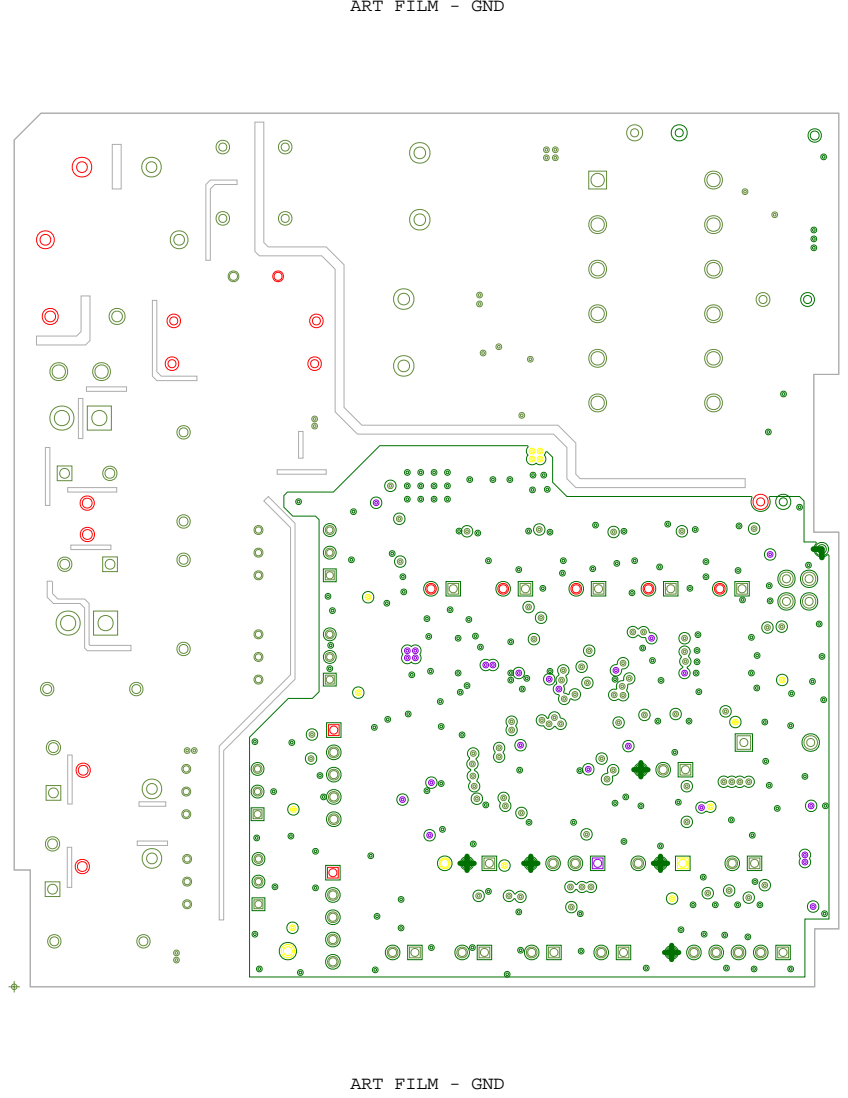
[picture p23: page 10]

ART FILM - GND

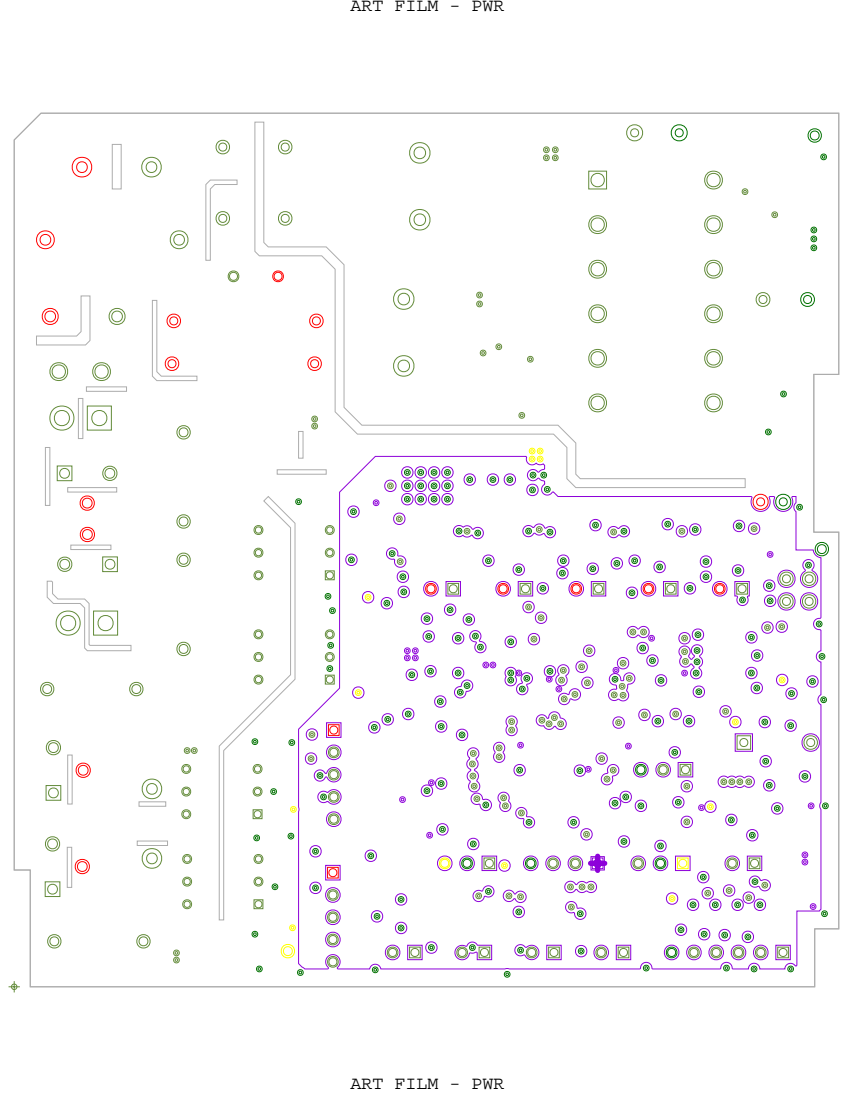
[picture p24: page 11]

ART FILM - PWR
