tonyzhangforest/Intelligent-Toilet-Controller/PMIC.pdf

# PMIC RK809 DCDC

# PMIC RK809 LDO

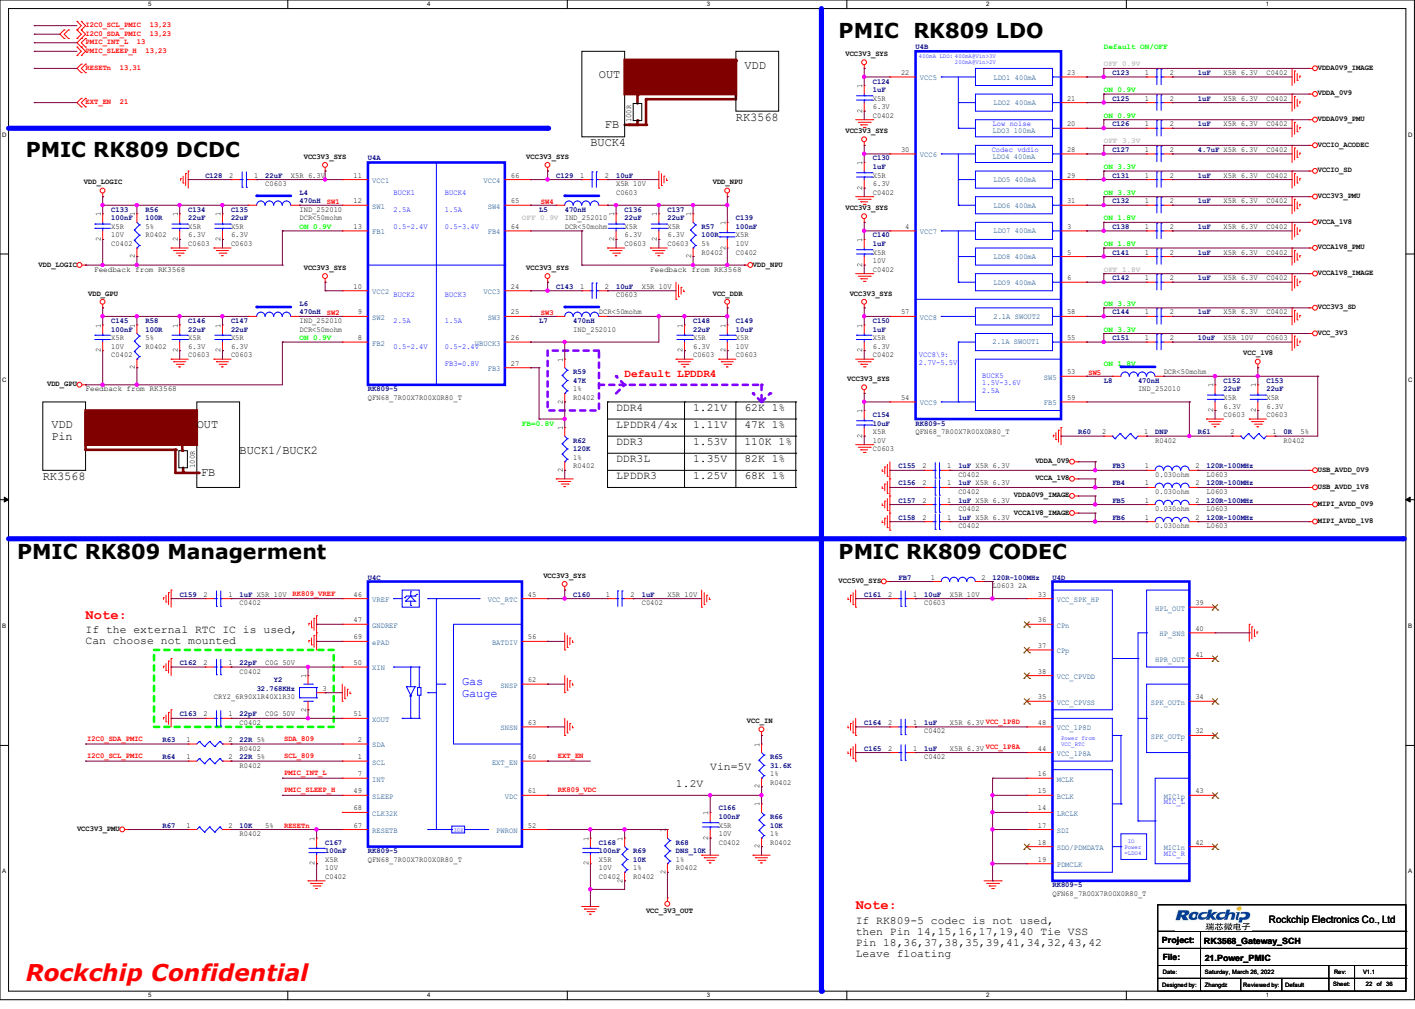
[picture p25: page 1]

DDR4 | 1.21V | 62K 1%
LPDDR4/4x | 1.11V | 47K 1%
DDR3 | 1.53V | 110K 1%
DDR3L | 1.35V | 82K 1%
LPDDR3 | 1.25V | 68K 1%

Note: If the external RTC IC is used,

Can choose not mounted

Note:
If RK809-5 codec is not used,
then Pin 14,15,16,17,19,40 Tie VSS
Pin 18,36,37,38,35,39,41,34,32,43,42
Leave floating
