tonyzhangforest/Intelligent-Toilet-Controller/bc7277_disp.pdf

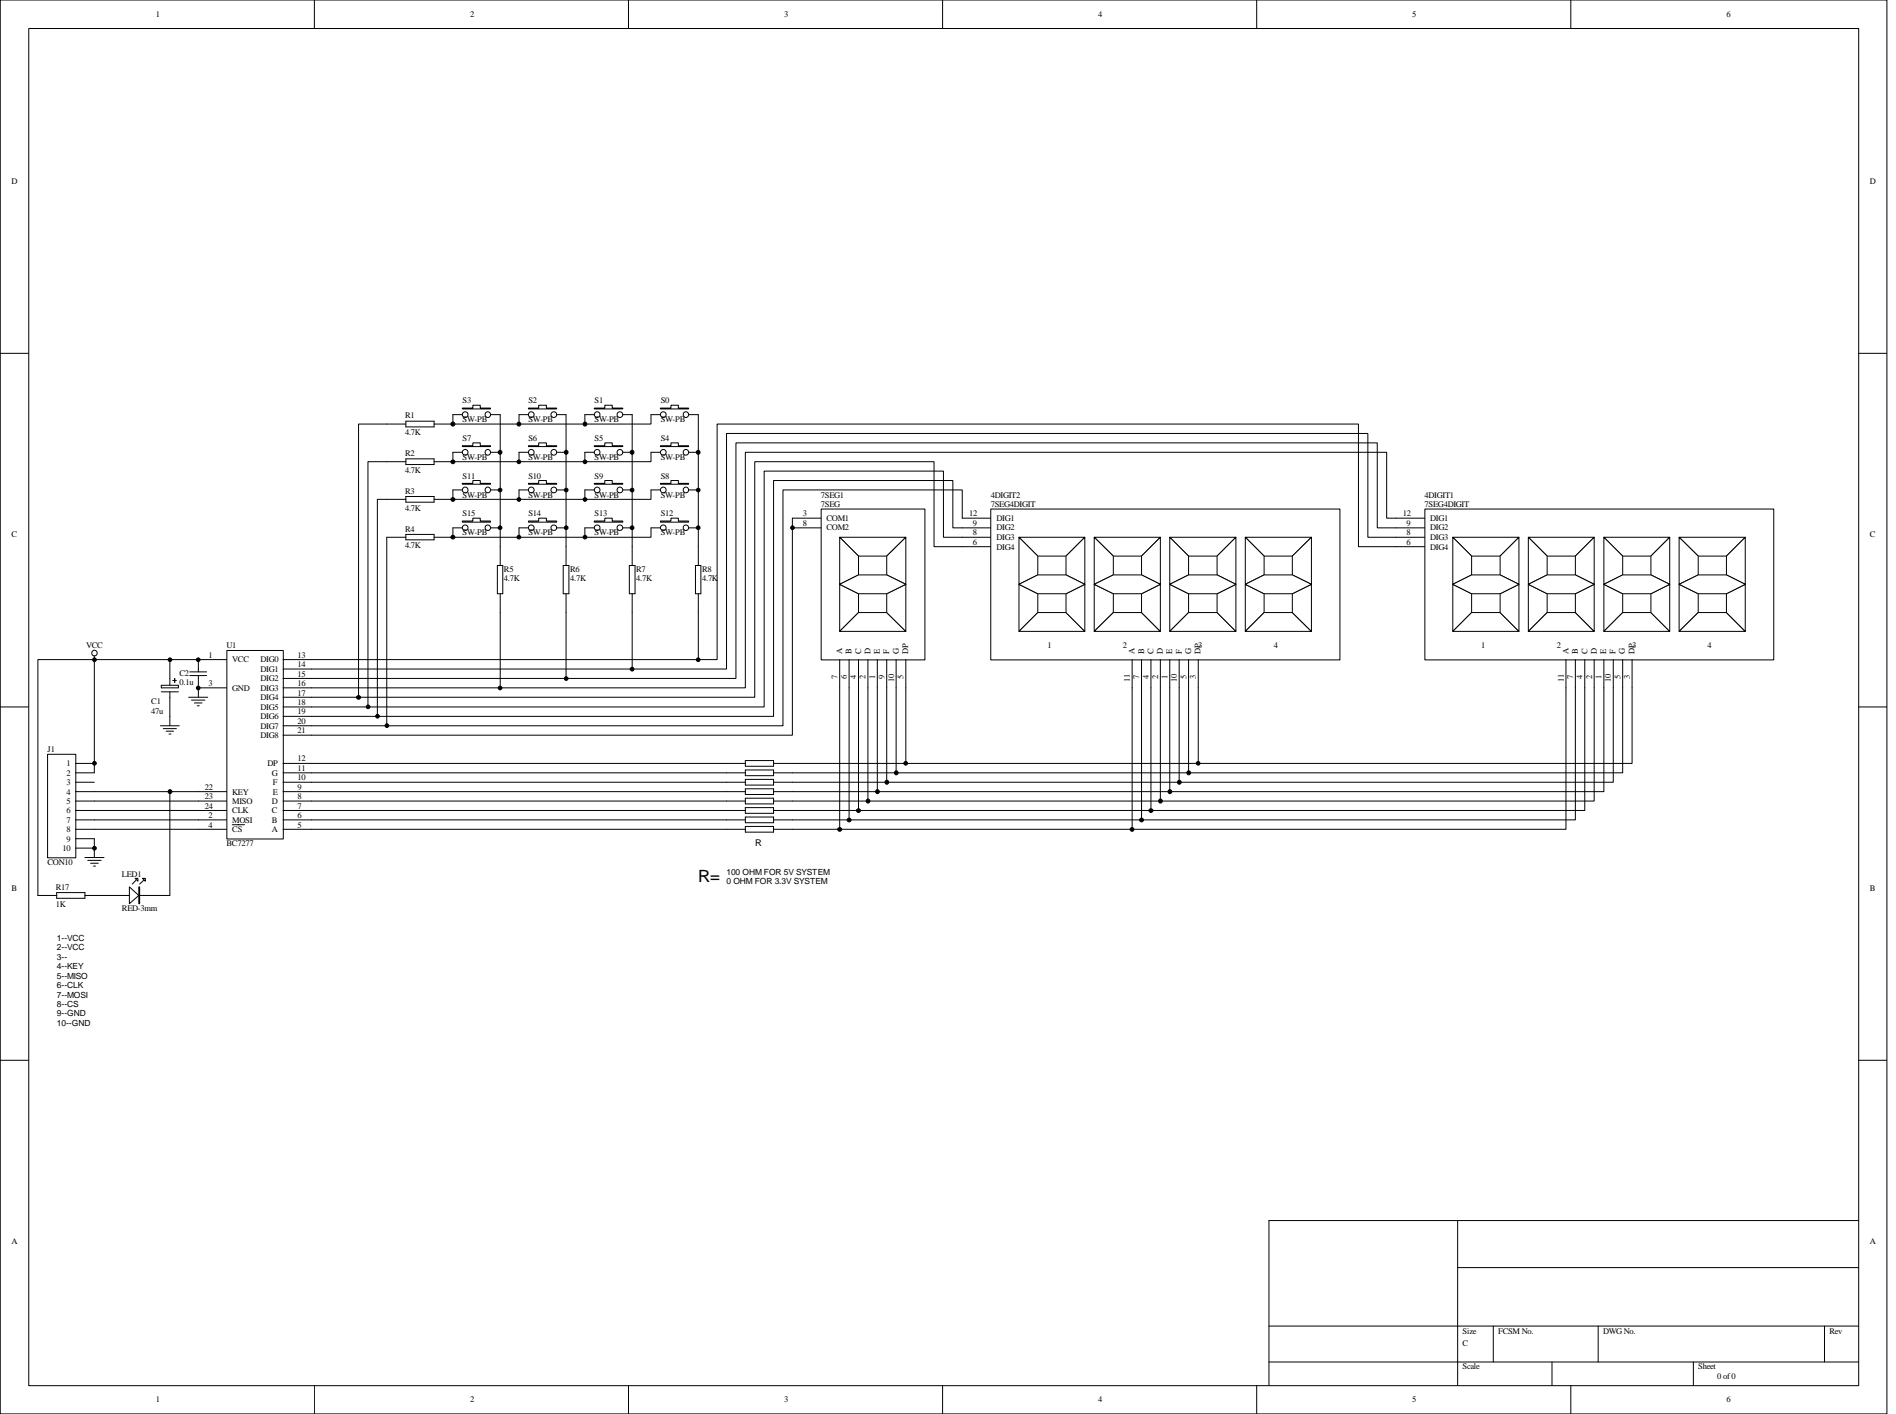
[picture p26: page 1]

100 OHM FOR 5V SYSTEM R= 0 OHM FOR 3.3V SYSTEM
