tonyzhangforest/Intelligent-Toilet-Controller/ACDriver.pdf

5

4

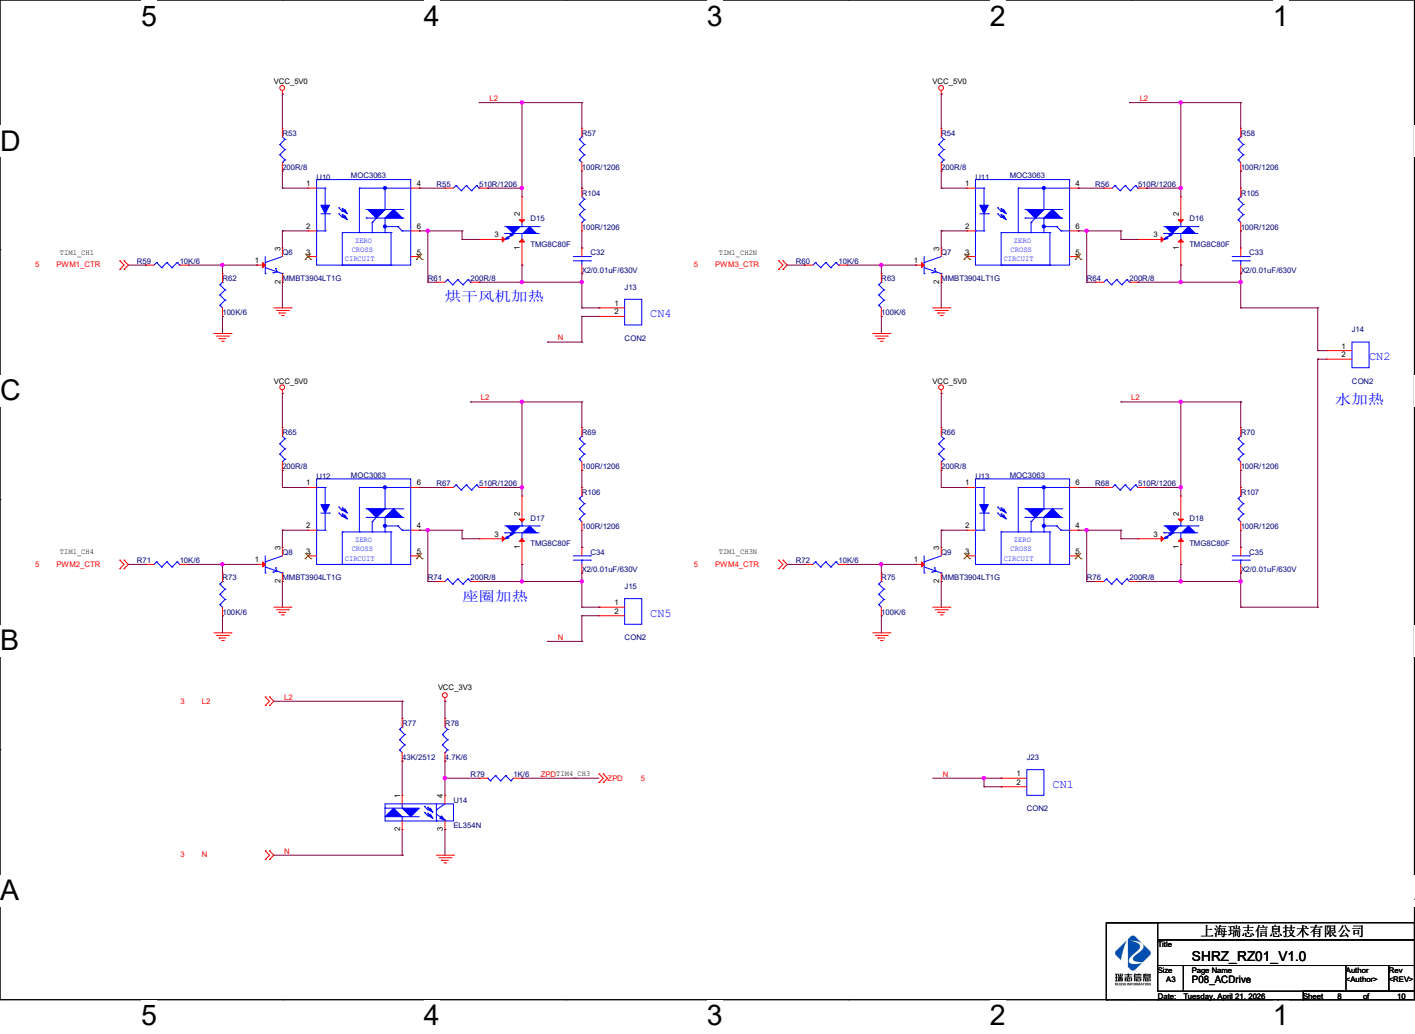
[picture p27: page 1]
