tonyzhangforest/Intelligent-Toilet-Controller/DCDriver.pdf

5

4

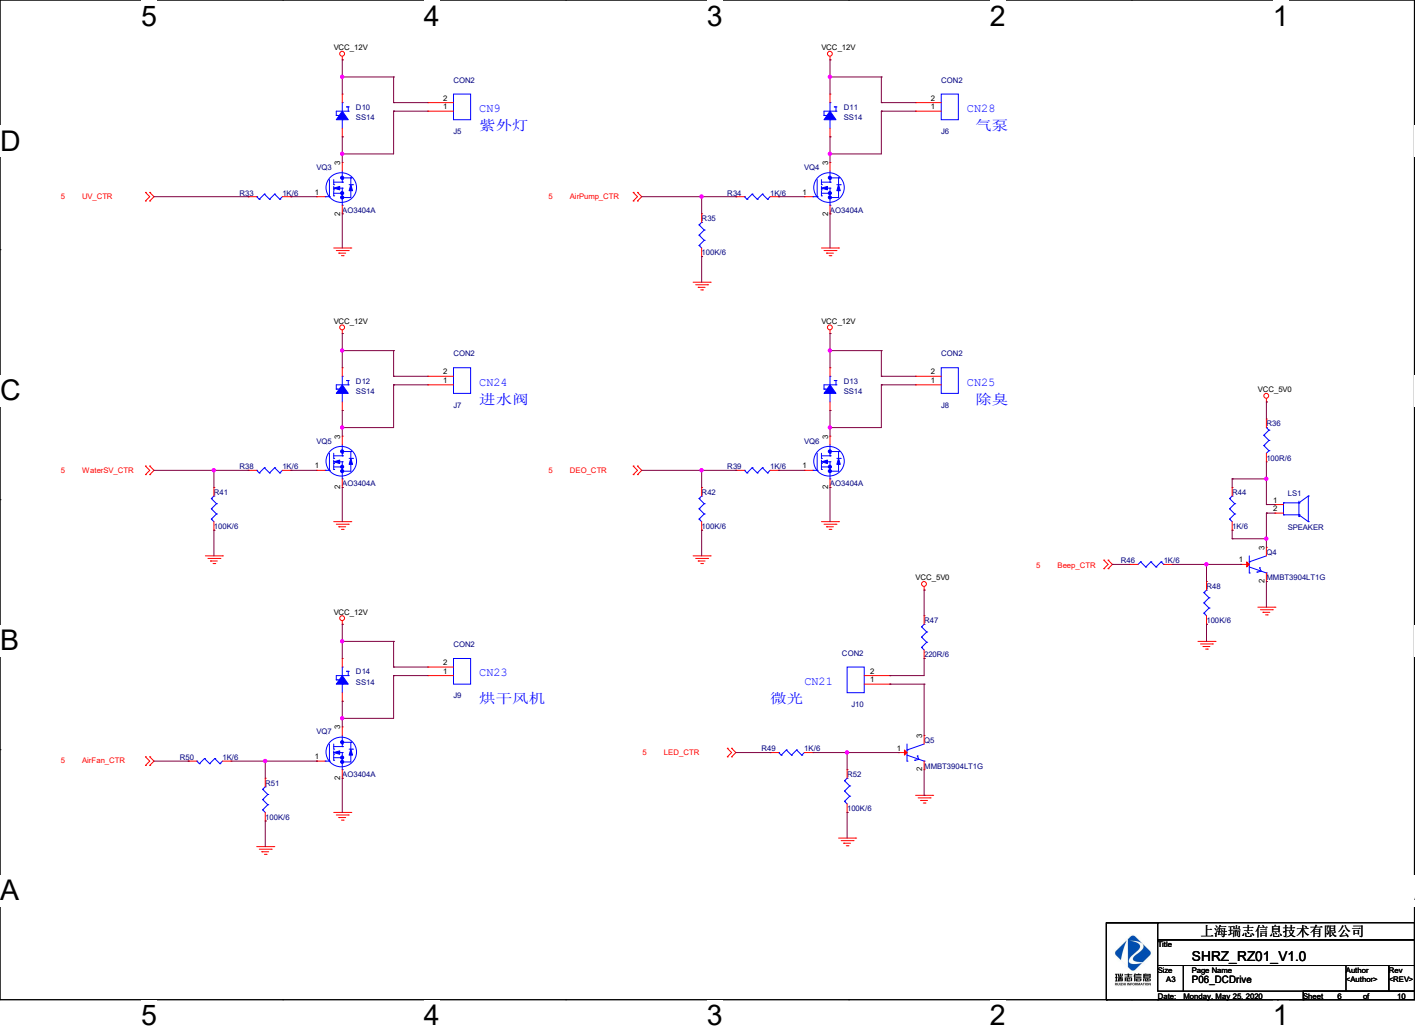
[picture p28: page 1]
