tonyzhangforest/Intelligent-Toilet-Controller/Detect.pdf

5

4

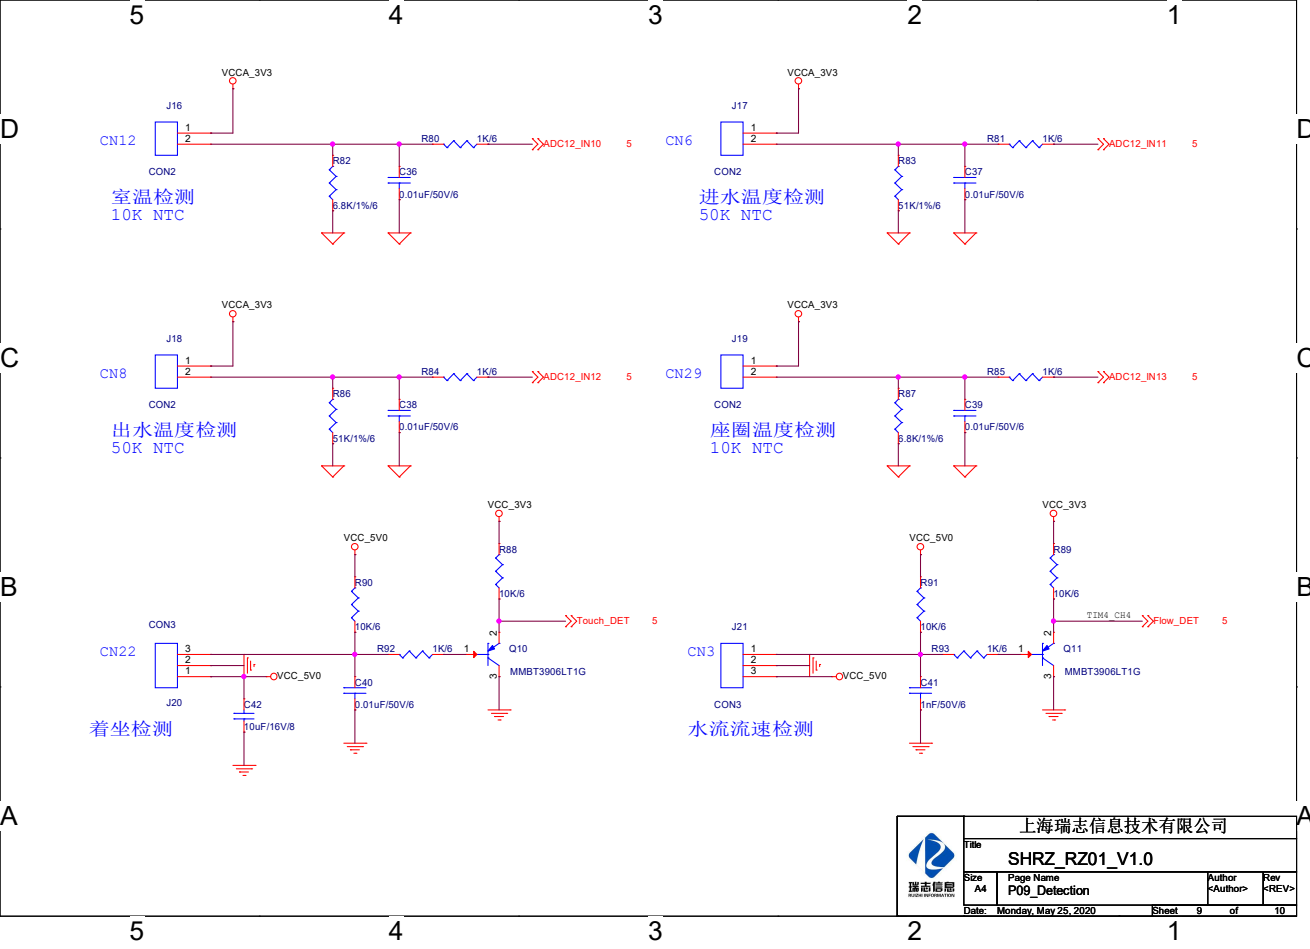
[picture p29: page 1]
