tonyzhangforest/Intelligent-Toilet-Controller/HMI.pdf

5

4

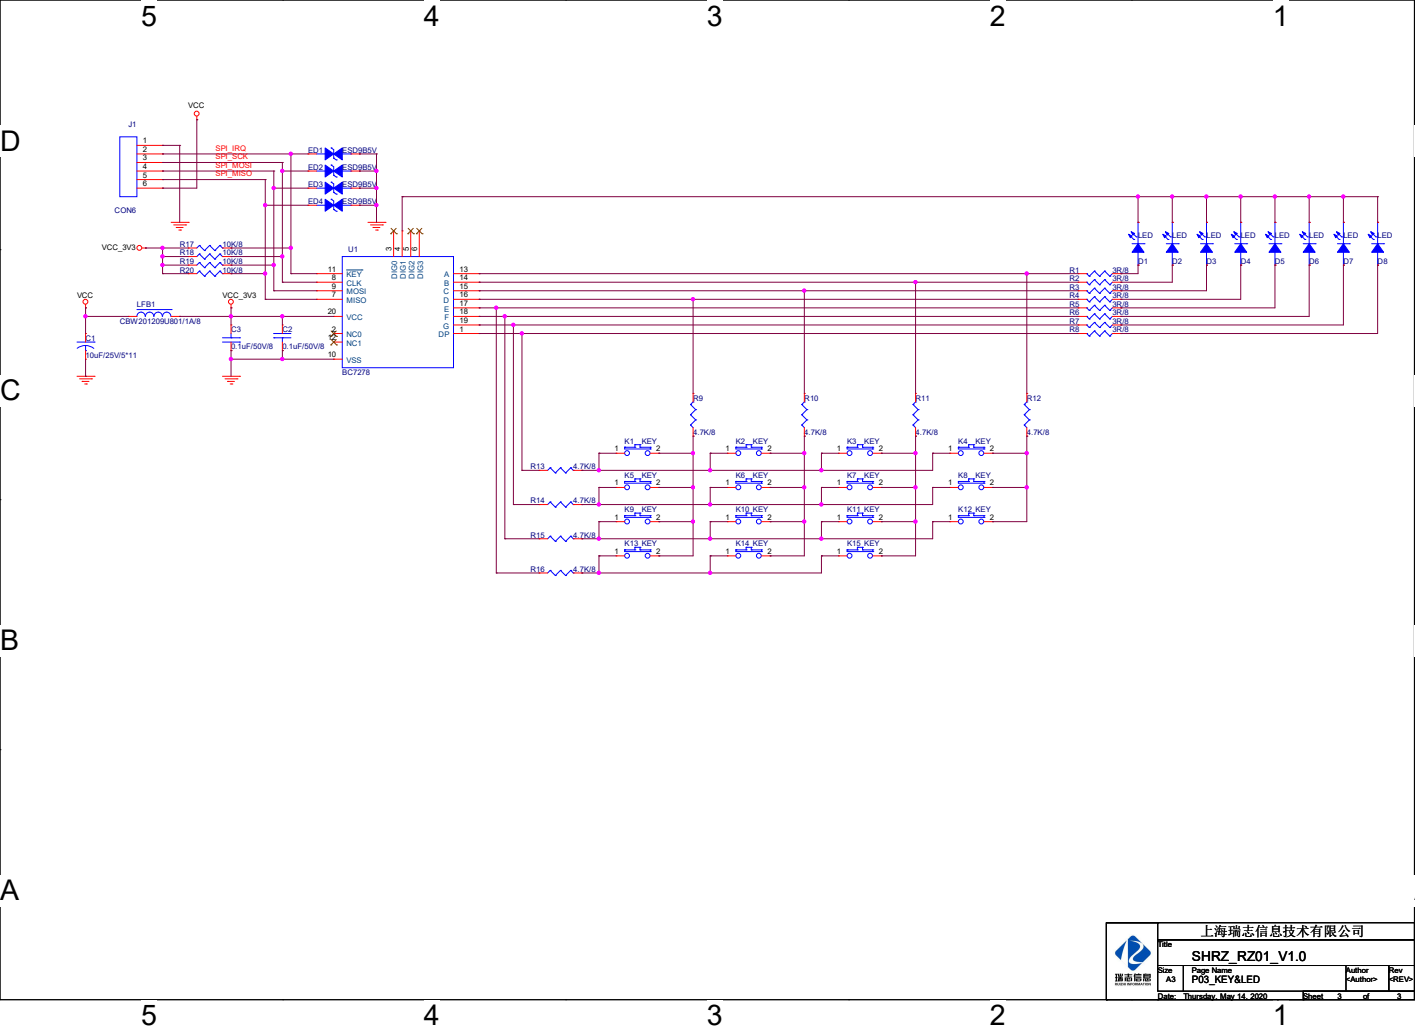
[picture p30: page 1]
