tonyzhangforest/Intelligent-Toilet-Controller/MCU.pdf

5

4

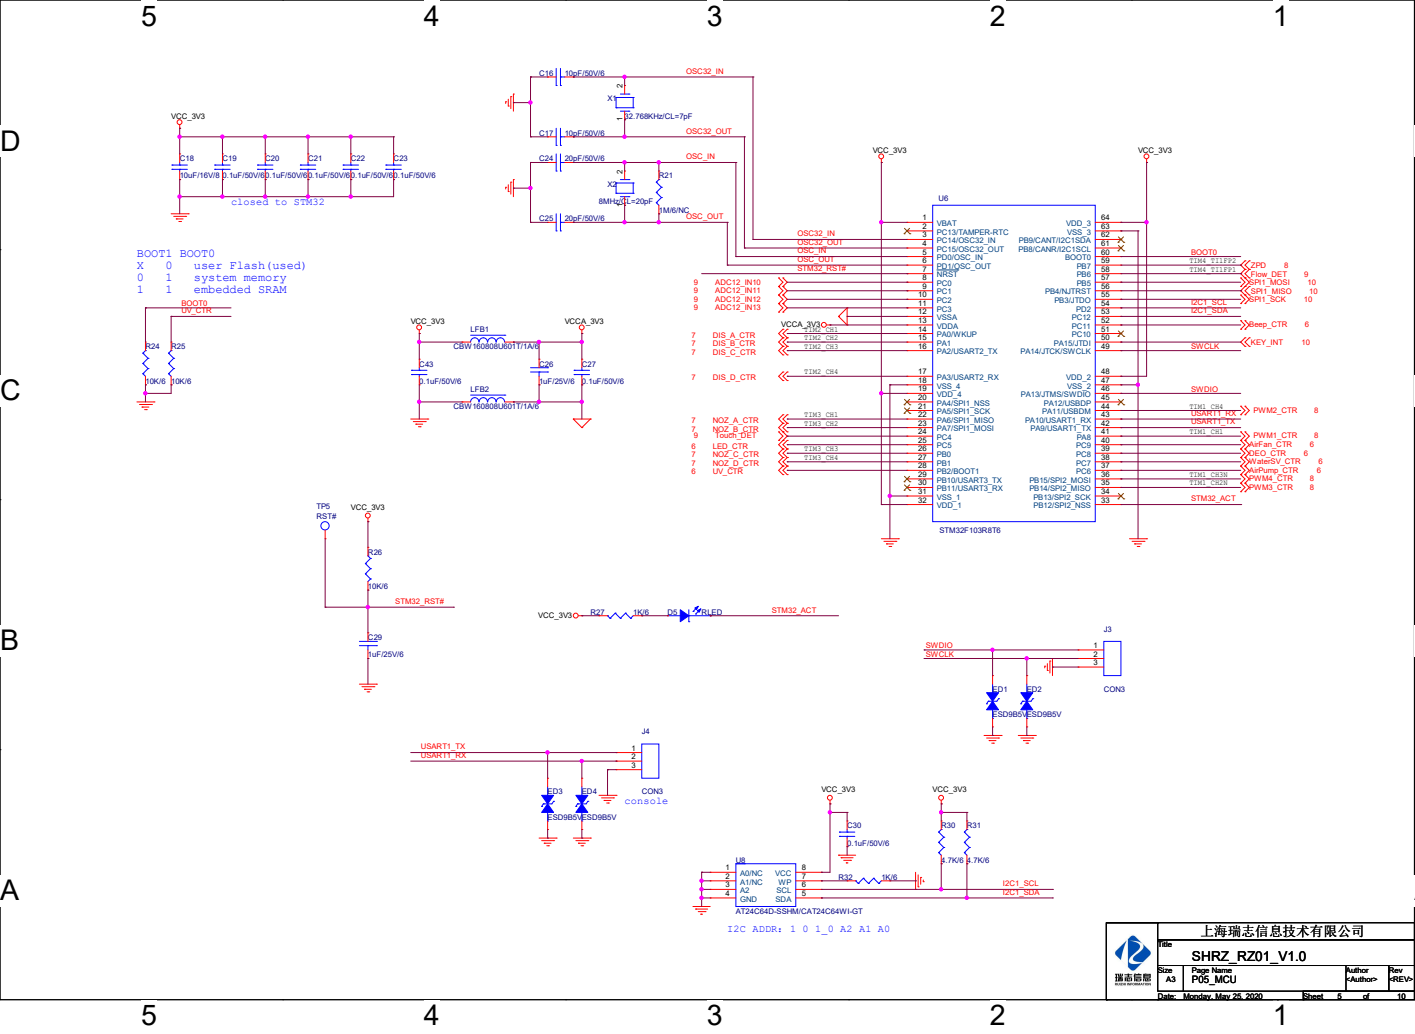
[picture p31: page 1]
