tonyzhangforest/Intelligent-Toilet-Controller/motor.pdf

CN17

## TP point lated on the top

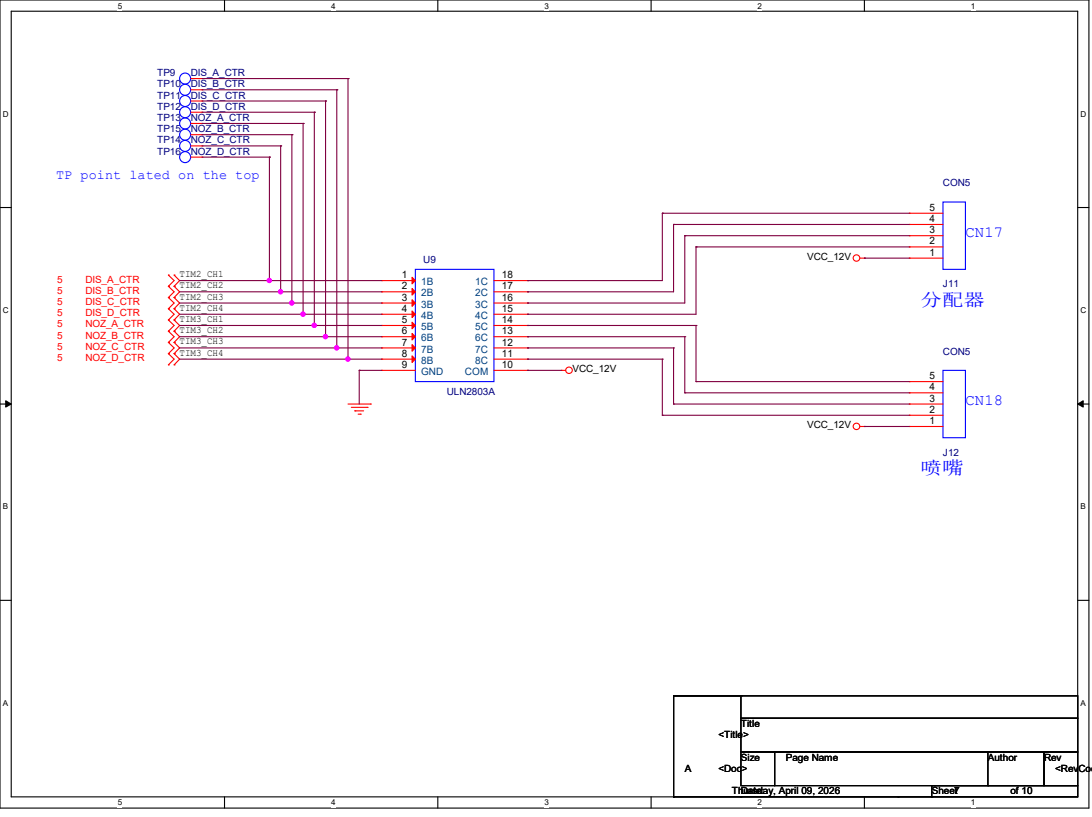
[picture p32: page 1]
