tonyzhangforest/Intelligent-Toilet-Controller/DC-DC.pdf

# J2 CONN RCPT 12x2

# 10uF R31

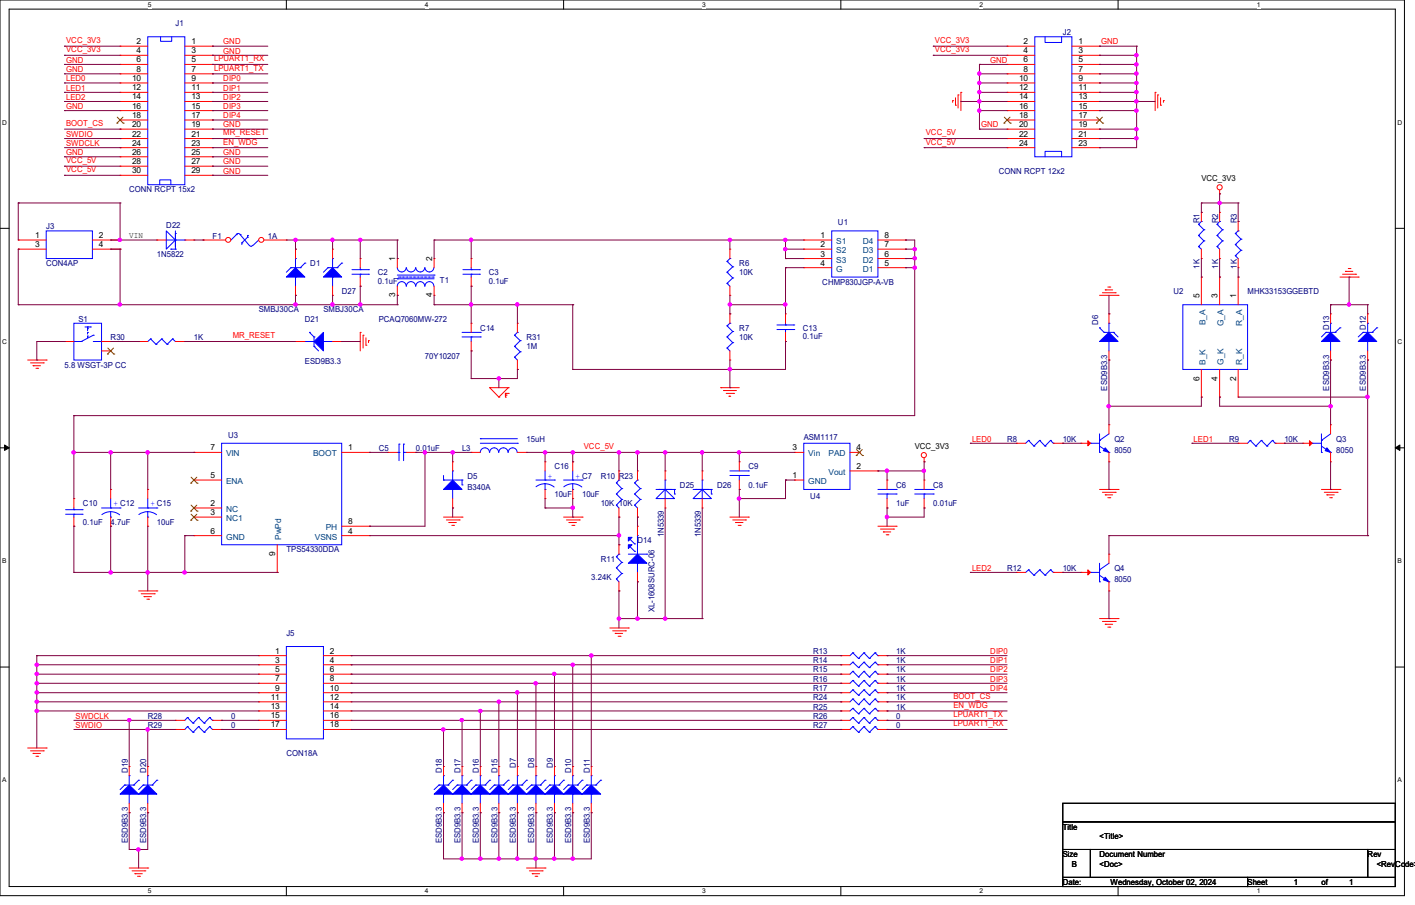
[picture p33: page 1]
