tonyzhangforest/Intelligent-Toilet-Controller/BC7278.pdf

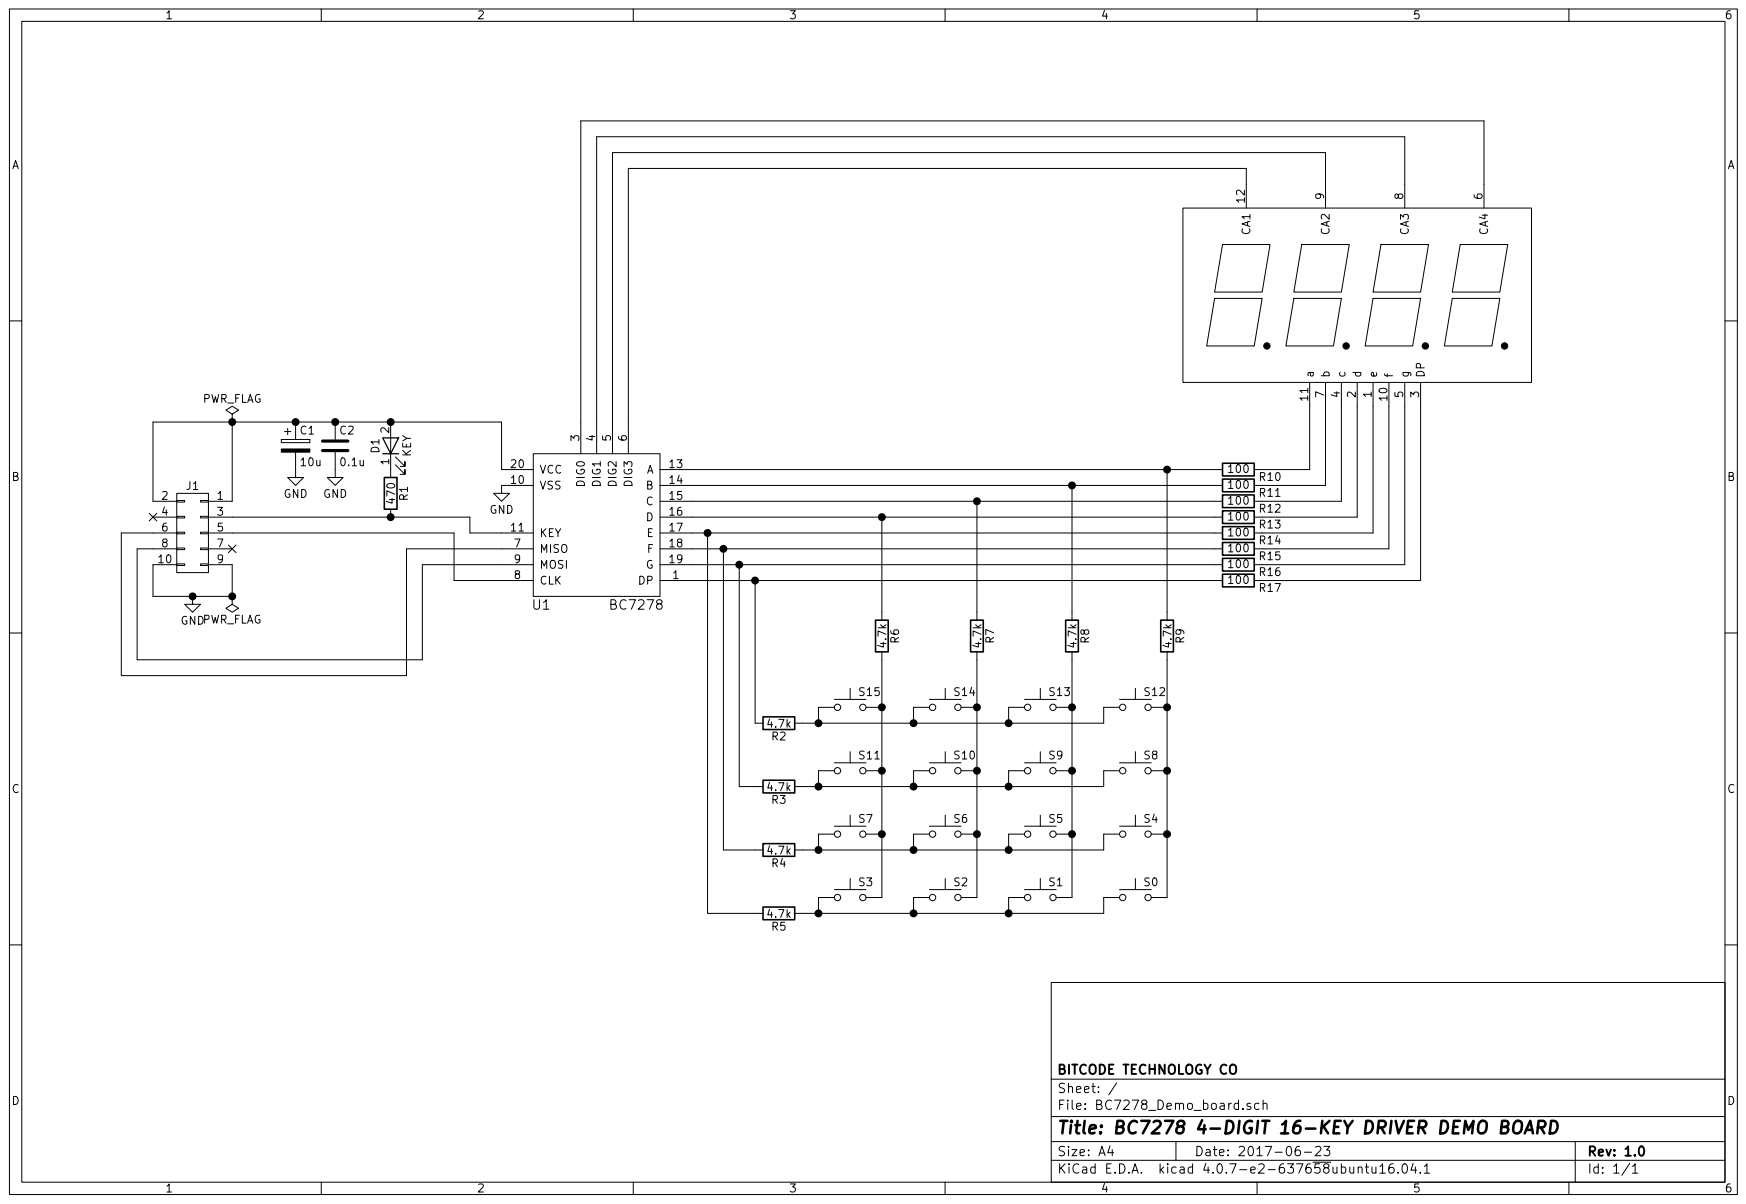
[picture p34: page 1]
