tonyzhangforest/Intelligent-Toilet-Controller/(list of files, drawings)

Other design files:
SHRZ_RZ01_V1.2-20200525.DSN
